openAMRobot/openamr-platform-hw/datasheets/ZDmotor/README.md

Contact:
web: [https://zd-motor.com](https://www.zd-motor.com/)

> NINGBO ZHONGDA LEADER INTELLIGENT TRANSMISSION CO.,LTD.     
> trade26@zd-motor.com    
> sales@zd-motor.com
> 
> No.185 1ST,NEW INDUSTRIAL ZONE,ZONGHAN STREET,CIXI ZHEJIANG, CHINA, 315300     

**T: 86 0574 63537171**
