openAMRobot/openamr-platform-hw/datasheets/ZLTech/README.md

ZLTech components.
Wheel: ZLLG80ASM250-L V1.0
Driver: ZLAC8015D
