openAMRobot/openamr-platform-hw/datasheets/ZLTech/wheel_ZLLG80ASM250/readme.md

# ZLTECH ZLLG80ASM250 hub motor

| File | What |
|---|---|
| `ZLLG80ASM250-L-B2 V1.01 double-shaft.pdf` / `.STEP` / `.dwg` | **Selected 2.0 drivetrain part.** Double shaft, integrated brake, 1024-line encoder. Drawing dated 2026-10-09, received from ZLTECH on 2026-10-10. |
| `ZLLG80ASM250-L V3.0single-shaft.*` | Single-shaft version, reference only. |
| `ZLLG80ASM250-L V1.0.zip` | Earlier double-shaft package (2024), superseded by B2 V1.01. |

Key dimensions from the B2 V1.01 drawing: wheel diameter 200 ±2 mm, tyre width 49.4 ±1 mm, hub width 59.2 mm, overall length shaft end to shaft end 167.8 ±0.5 mm, 83.8 ±1 mm from the tyre face to the brake-side shaft end, 40 ±0.5 mm brake-side shaft, shafts M14 x 1.5 with 10 mm flats, cable 600 ±50 mm.
Motor data on the drawing: 24 V, 5.5 Nm rated, 16 Nm peak, 6.5 A rated, 19 A peak, 200 rpm rated, 260 rpm peak, 15 pole pairs, tyre rubber Shore A 65 ±5.
**Maximum load: 120 kg per pair** (ZLTECH written answer of 18 Oct 2026). The B2 V1.01 drawing states 100 kg per 2 sets.
Brake per ZLTECH written answer of 18 Oct 2026: power-off brake (engaged with power off), 24 V DC, 12.5 W per motor, 6 Nm holding torque, release time at most 100 ms, engagement time at most 30 ms without a diode or at most 100 ms with a diode. These brake values are not on the drawing.
