openAMRobot/openamr-platform-hw/datasheets/Benewake/TF-Luna/readme.md

# Benewake TF-Luna references

Retrieved 18 October 2026. The vendor supplied both PDFs as en.pdf, so the original filenames are retained in separate subfolders.

## Datasheet/en.pdf
- Source: https://ai.benewake.com/en/resources/technical-documents/tf-luna-datasheet/
- Document: PD-TF-Luna-Datasheet-A05
- Revision: A05
- Date: ©2024; no specific issue date printed
- SHA-256: d080033ececa32866ed9361ae04f6d25d8dbdcd478cd2961be0360b241249718
- OpenAMRobot document: OpenAMRobot_NUCLEO-H723ZG_Pin_Map_Draft.docx

## User-Manual/en.pdf
- Source: https://ai.benewake.com/en/resources/technical-documents/tf-luna-user-manual/
- Document: TF-Luna User Manual; no document number printed
- Revision/date: REV: 01/04/2024; ©2024
- SHA-256: 36dfae2e9d6a298624889c5036cfdef9b191c9f44239b7f58ffcef685d9c28e7
- OpenAMRobot document: OpenAMRobot_NUCLEO-H723ZG_Pin_Map_Draft.docx
