openAMRobot/openamr-platform-hw/datasheets/ZDmotor/Driver_ZD_article.jpg

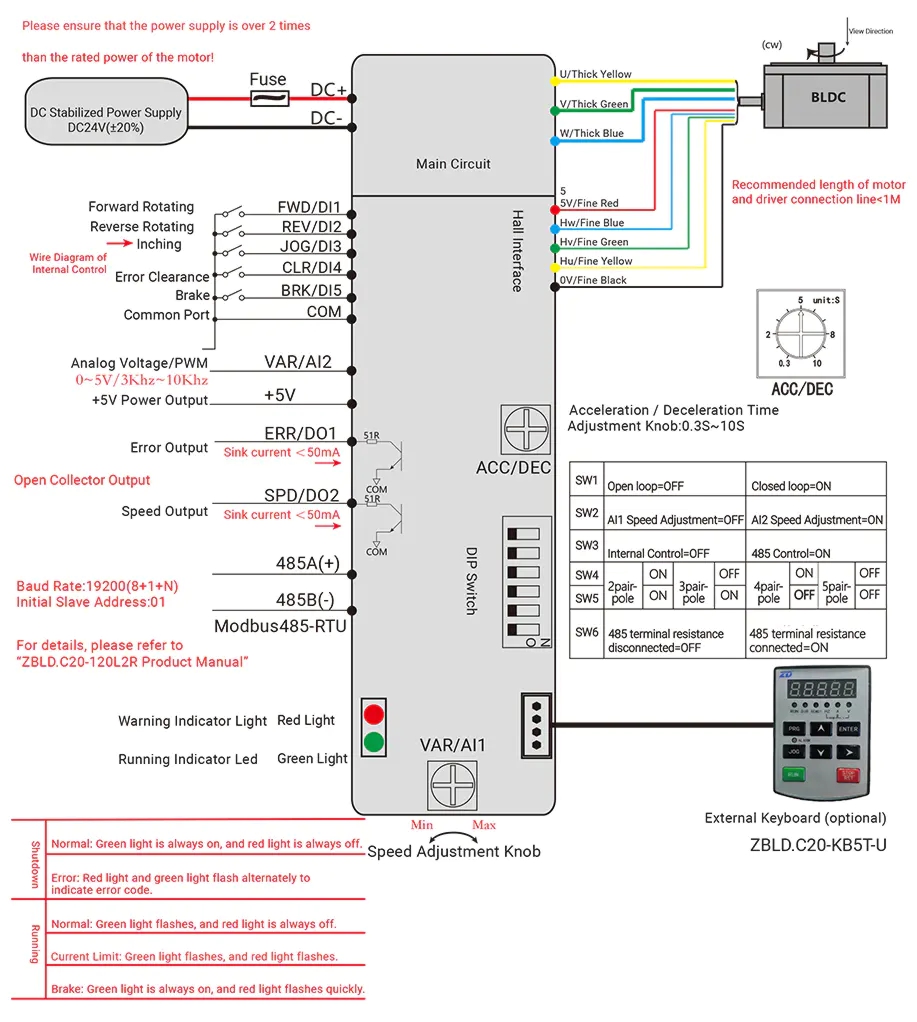
datasheets/ZDmotor/Driver_ZD_article.jpg
