openAMRobot/openamr-platform-hw/mechanical/renderings/AMR_bottom_view.png

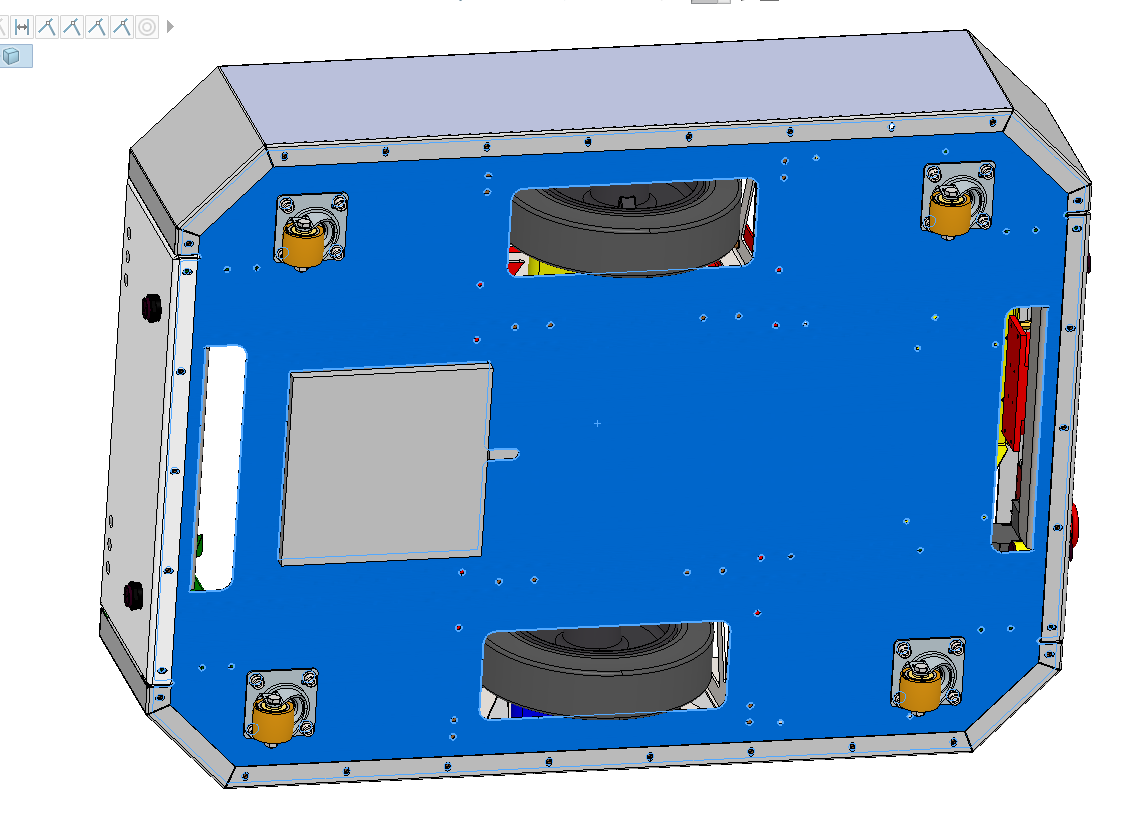
mechanical/renderings/AMR_bottom_view.png
