openAMRobot/openamr-platform-hw/mechanical/renderings/AMR_front_view_trasparent.png

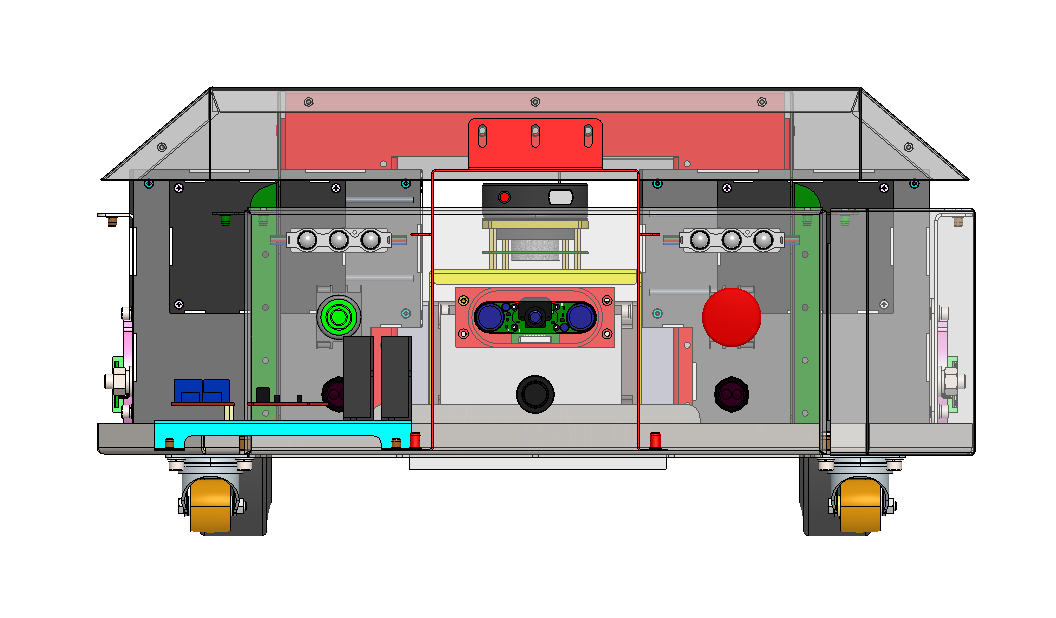
mechanical/renderings/AMR_front_view_trasparent.png
