openAMRobot/openamr-platform-hw/mechanical/renderings/AMR_side_view.jpg

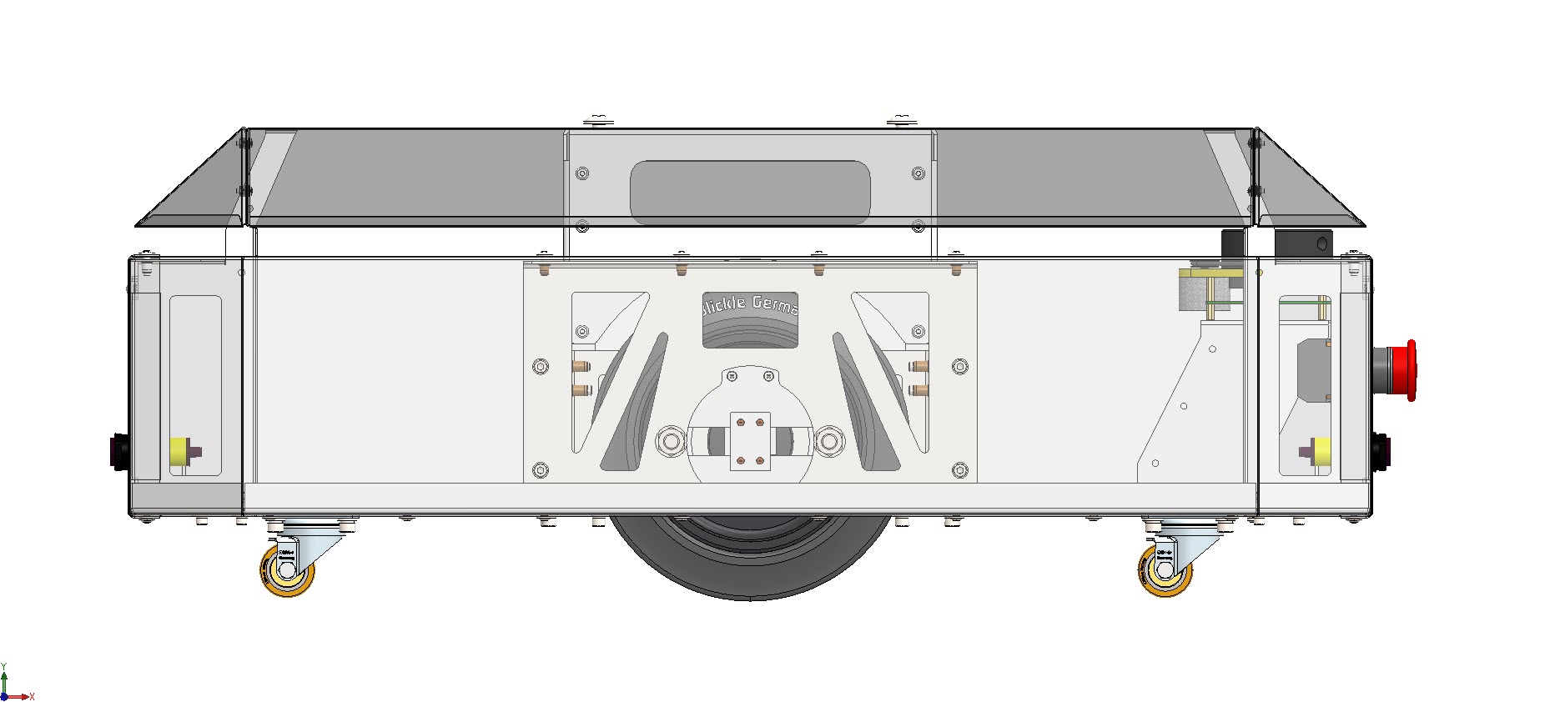
mechanical/renderings/AMR_side_view.jpg
