openAMRobot/openamr-platform-hw/mechanical/renderings/AMR_side_view_transparent.png

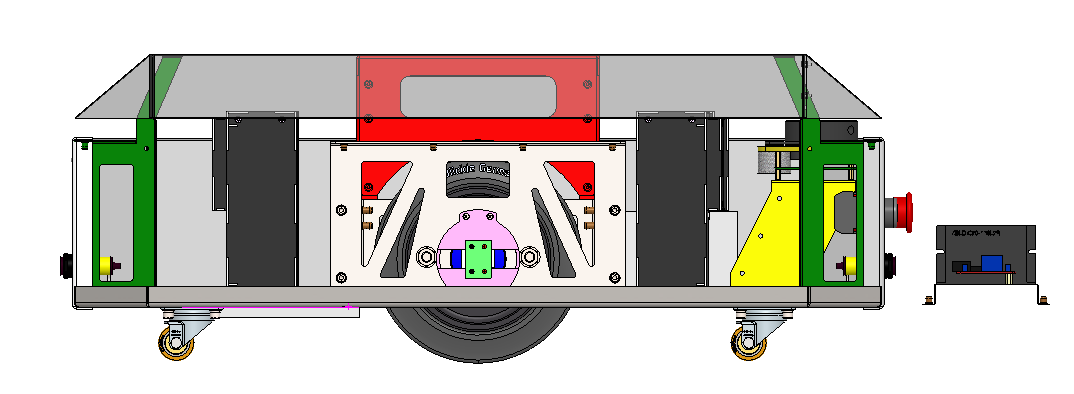
mechanical/renderings/AMR_side_view_transparent.png
