openAMRobot/openamr-platform-hw/mechanical/renderings/AMR_views.jpg

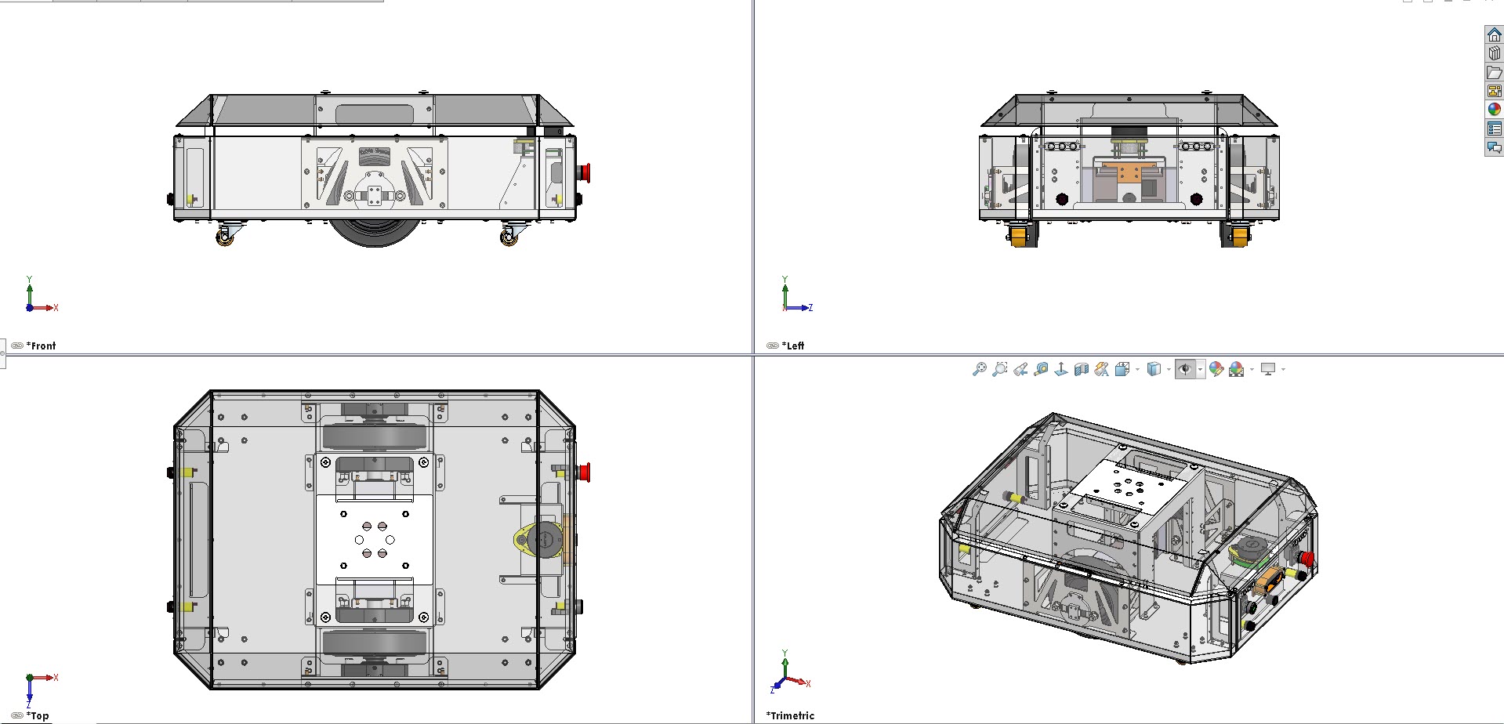
mechanical/renderings/AMR_views.jpg
