openAMRobot/openamr-platform-hw/mechanical/renderings/MMP_01.jpg

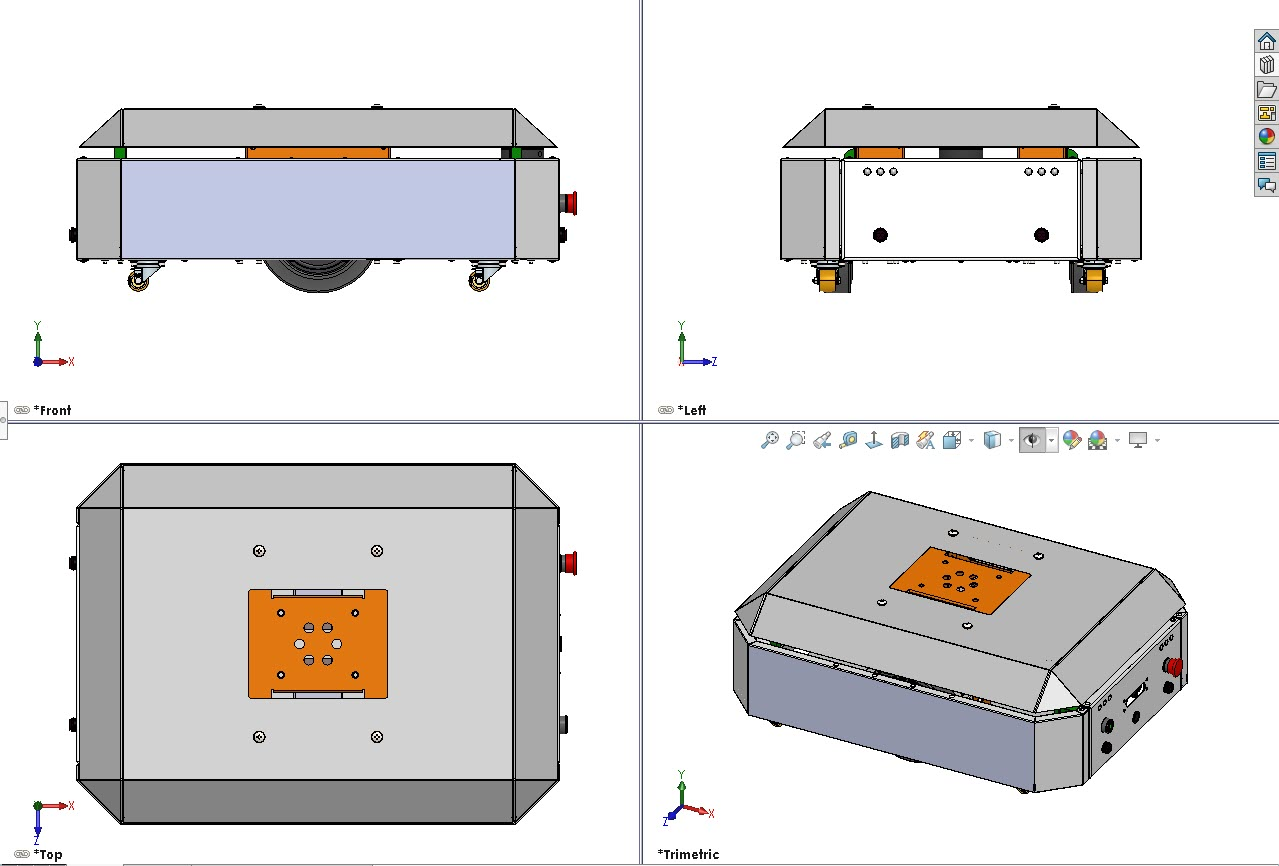
mechanical/renderings/MMP_01.jpg
