openAMRobot/openamr-platform-hw/mechanical/renderings/MMP_02.jpg

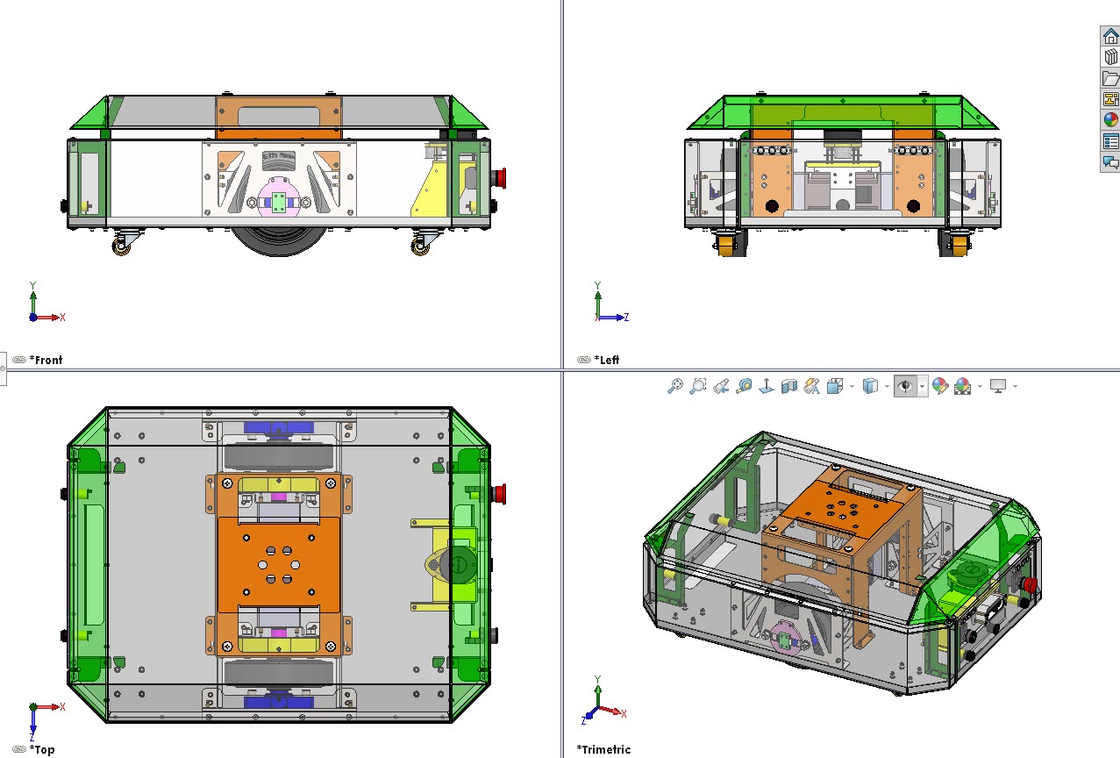
mechanical/renderings/MMP_02.jpg
