openAMRobot/openamr-platform-hw/mechanical/renderings/MMP_03.jpg

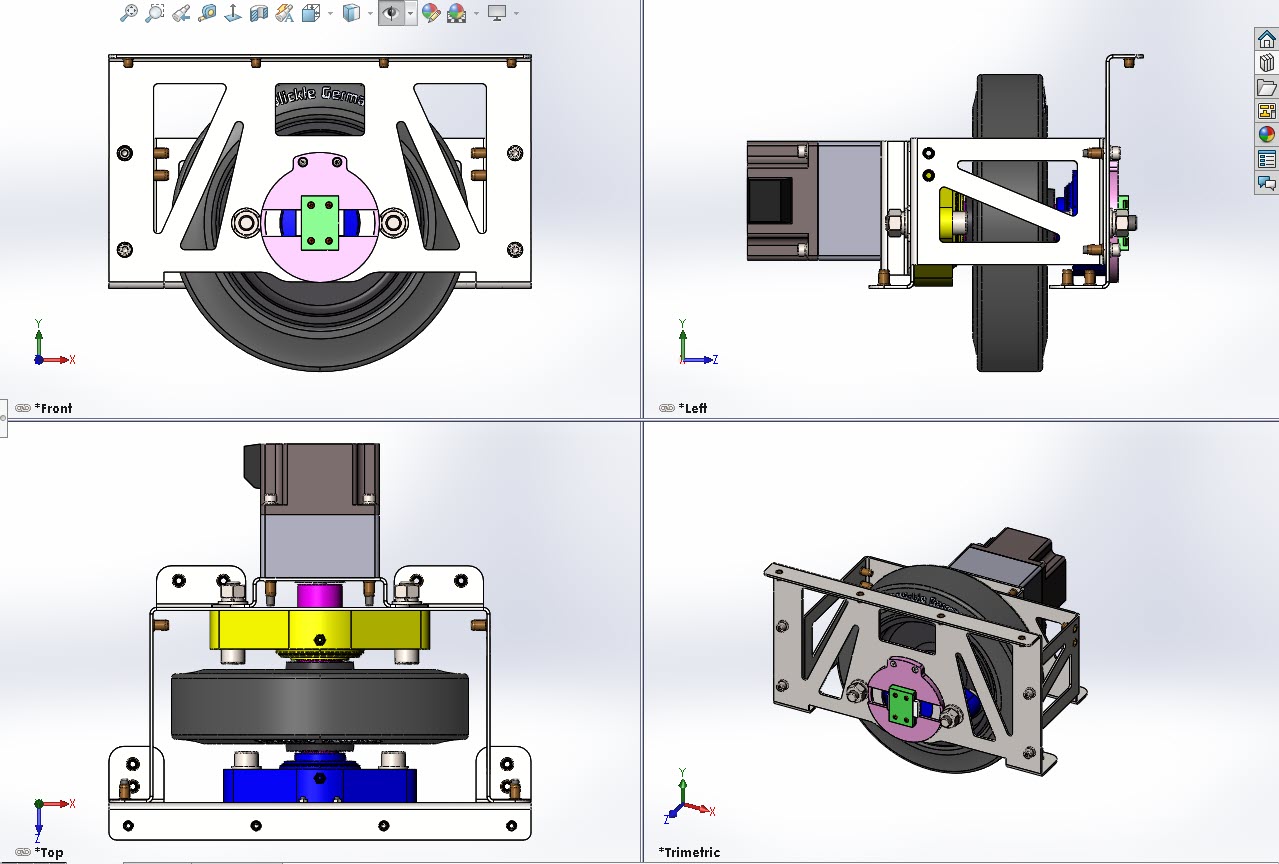
mechanical/renderings/MMP_03.jpg
