openAMRobot/openamr-platform-hw/mechanical/renderings/MMP_04.jpg

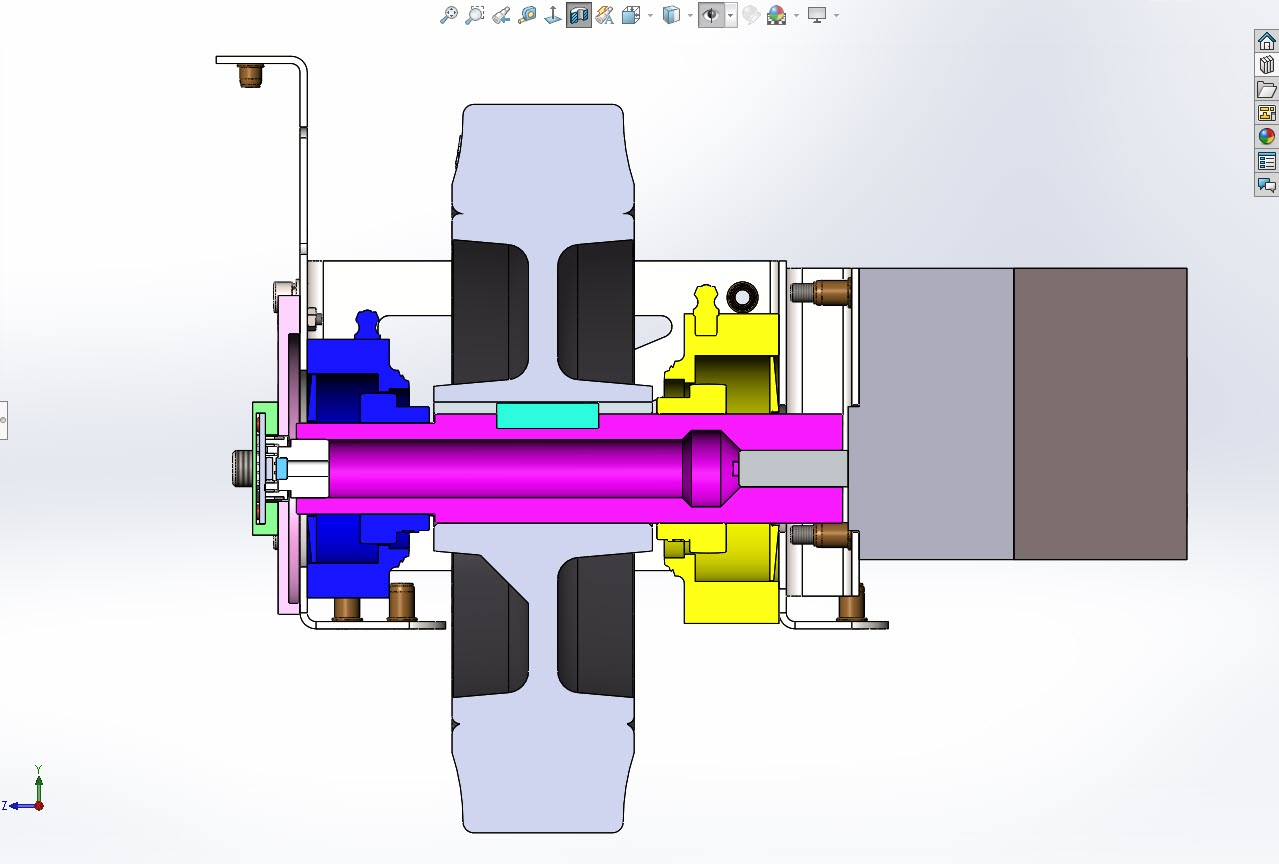
mechanical/renderings/MMP_04.jpg
