openAMRobot/openamr-platform-hw/mechanical/renderings/MMP_05.jpg

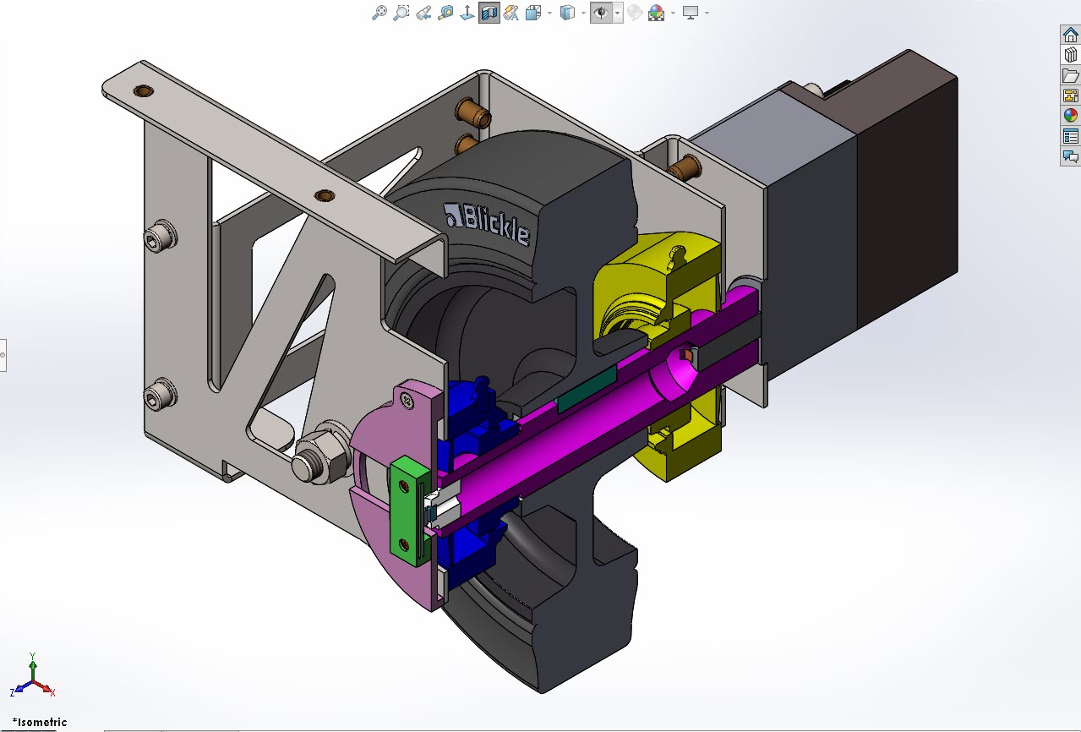
mechanical/renderings/MMP_05.jpg
