openAMRobot/openamr-platform-hw/mechanical/renderings/OpenAMR_03.png

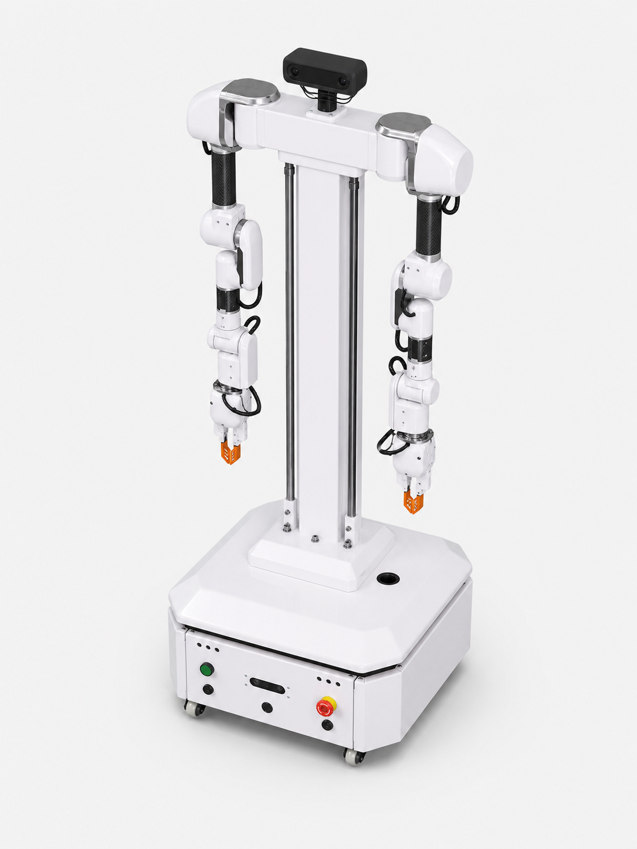
mechanical/renderings/OpenAMR_03.png
