openAMRobot/openamr-platform-hw/mechanical/renderings/OpenAMR_04.png

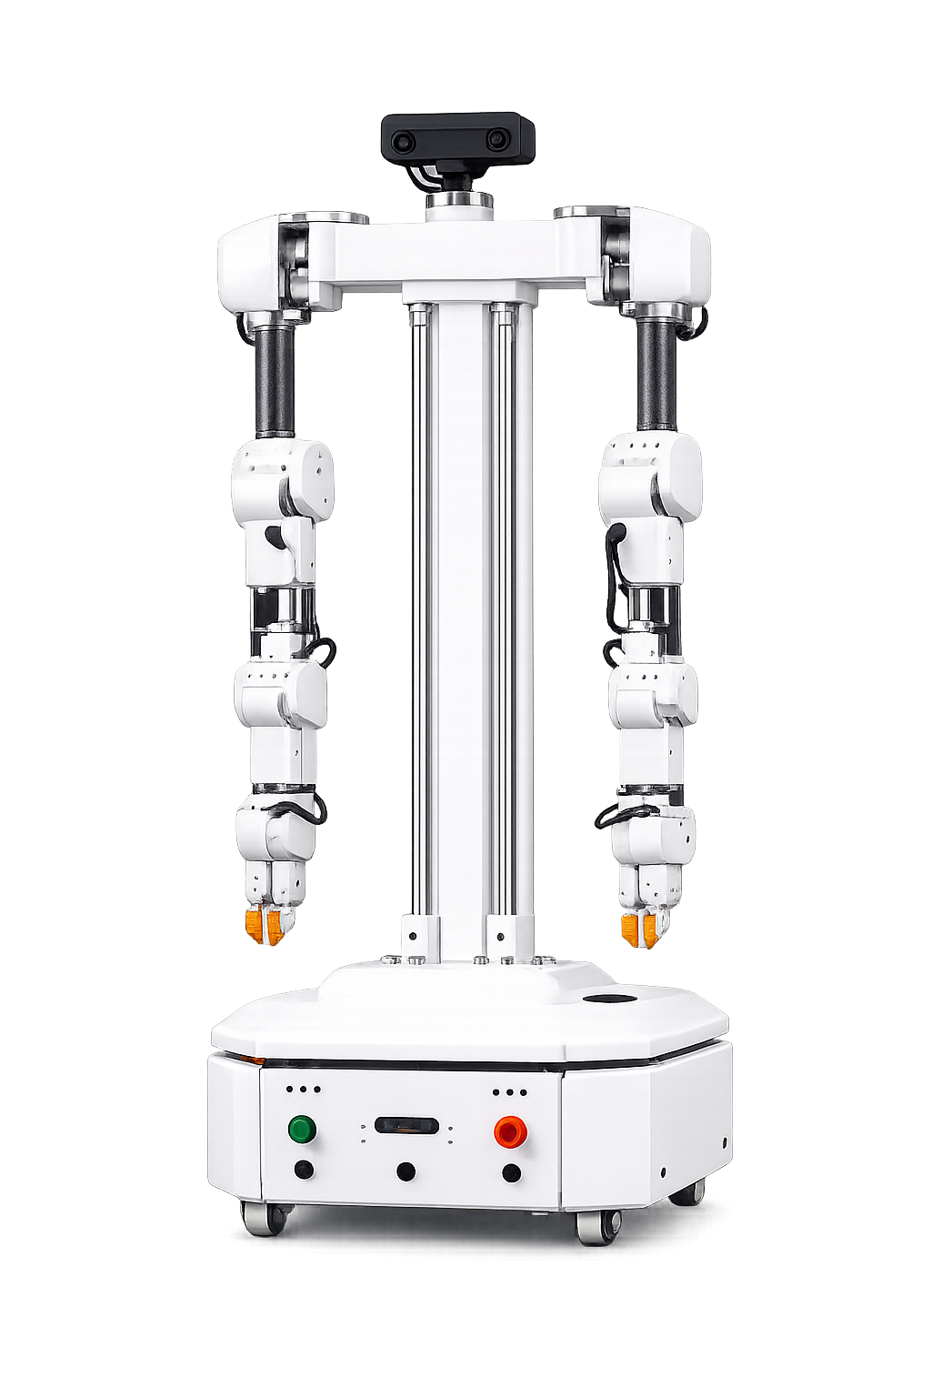
mechanical/renderings/OpenAMR_04.png
