openAMRobot/openamr-platform-hw/mechanical/renderings/OpenAMR_05.png

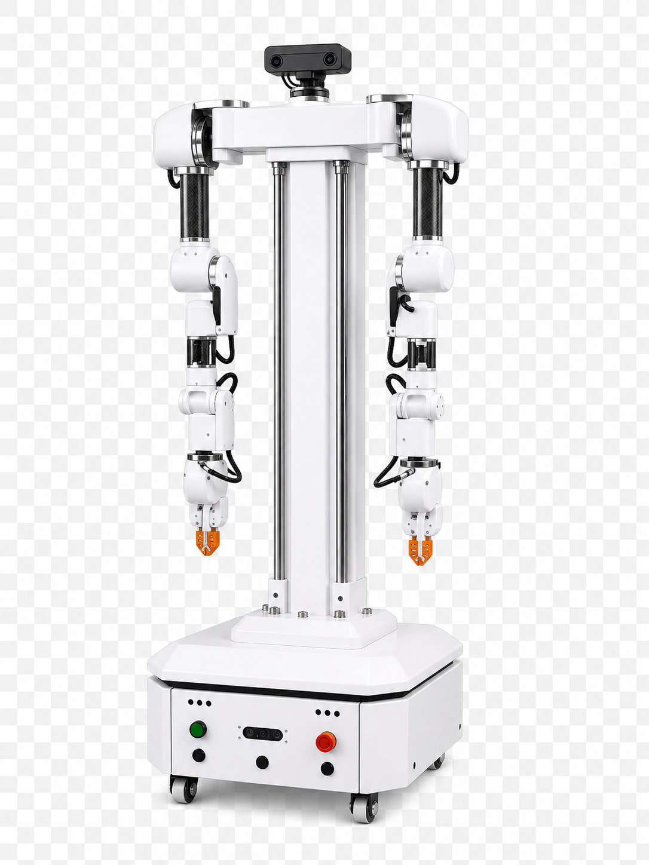
mechanical/renderings/OpenAMR_05.png
