openAMRobot/openamr-platform-hw/mechanical/renderings/OpenAMR_10.png

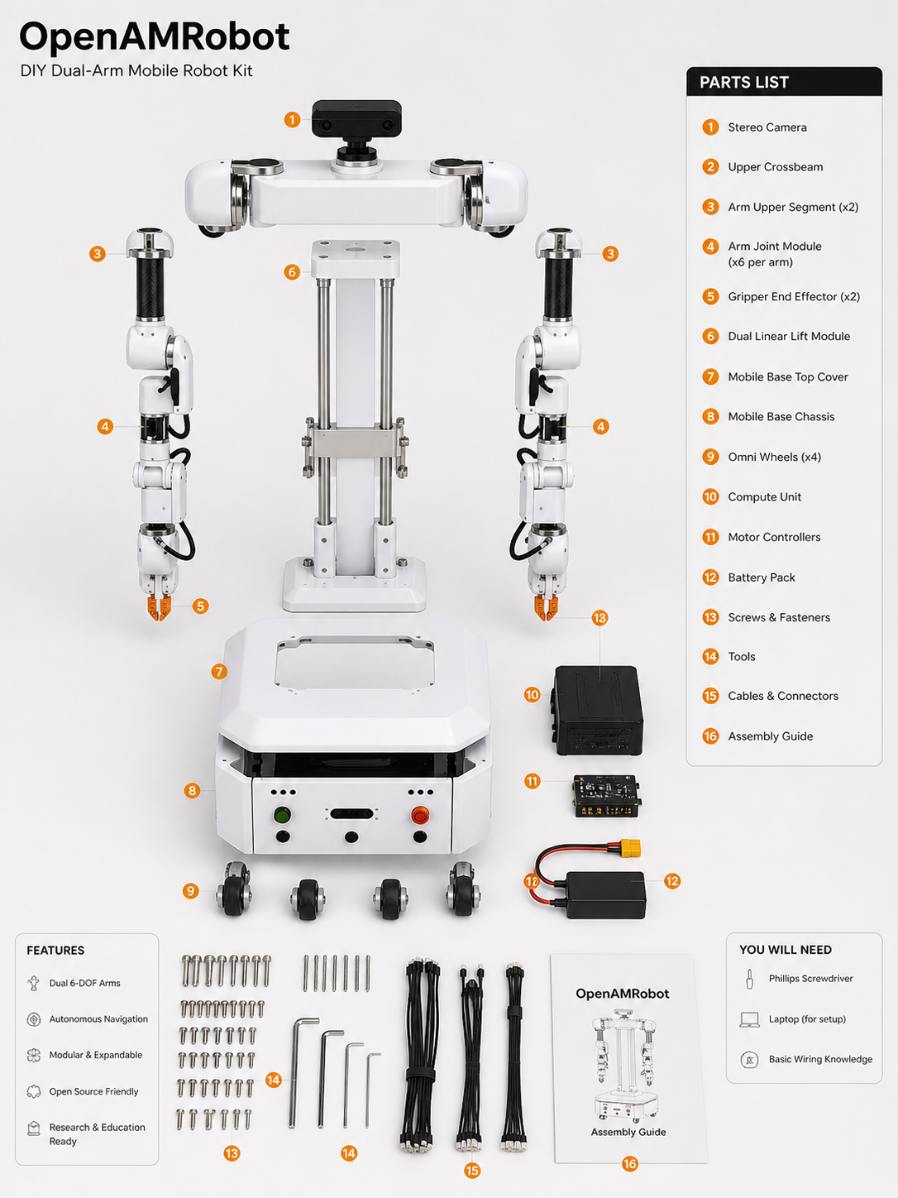
mechanical/renderings/OpenAMR_10.png
