openAMRobot/openamr-platform-hw/mechanical/renderings/OpenAMR_15_c.png

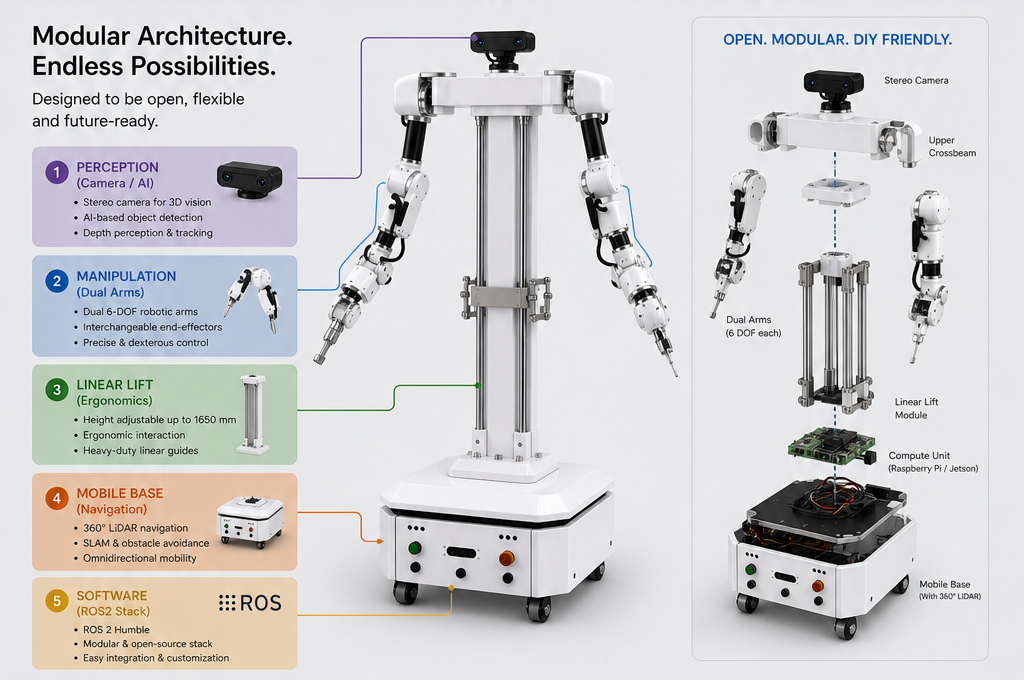
mechanical/renderings/OpenAMR_15_c.png
