openAMRobot/openamr-platform-hw/mechanical/renderings/OpenAMRobot_AI_ecosystem.png

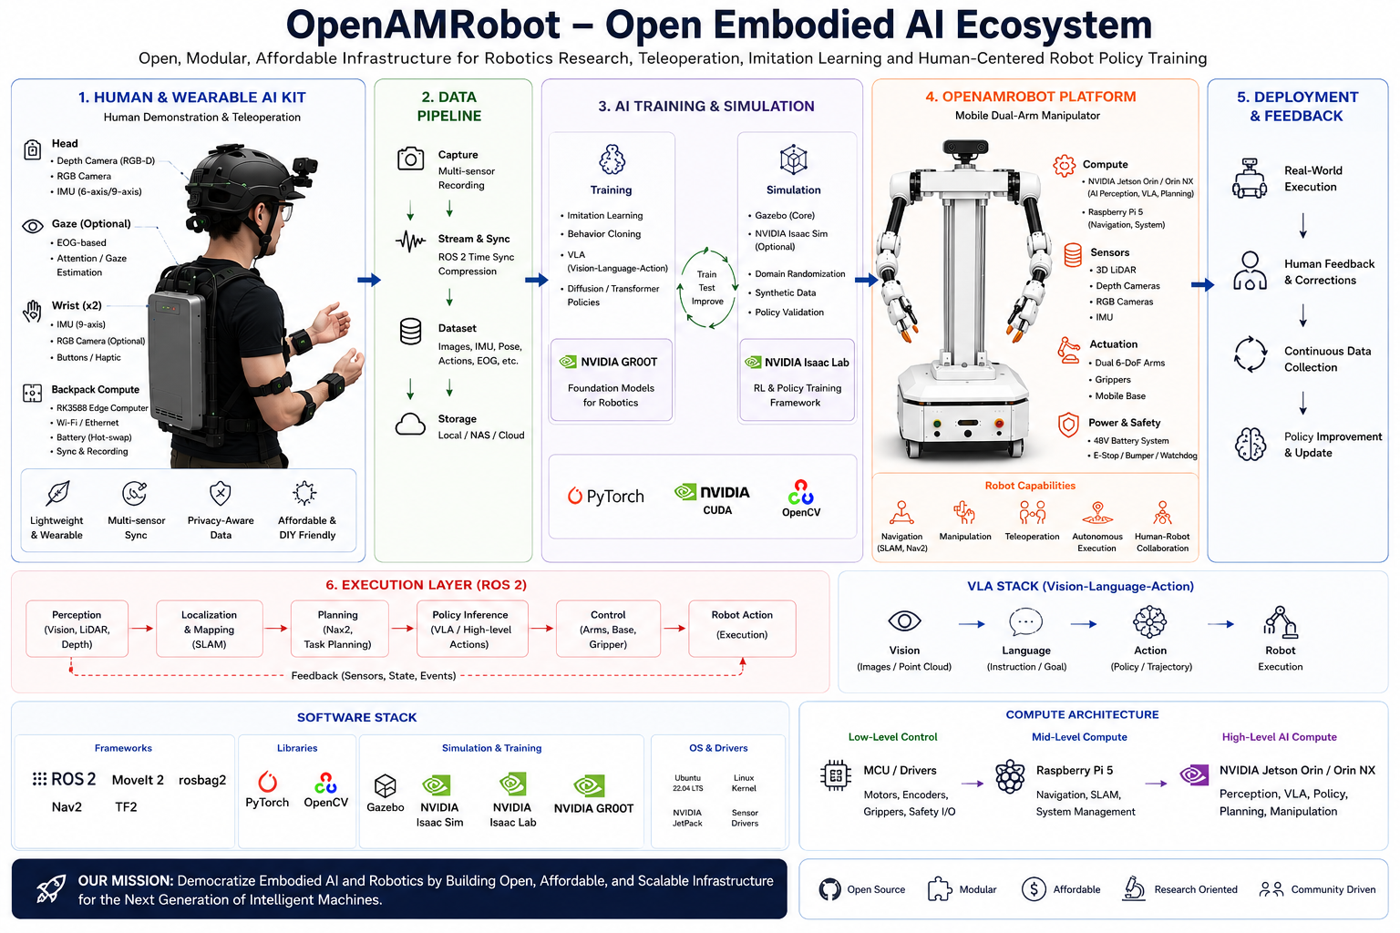
mechanical/renderings/OpenAMRobot_AI_ecosystem.png
