openAMRobot/openamr-platform-hw/manufacturing/bom/components-bom.md

# Components — Bill of Materials & datasheets

*Last updated: 2026-06-19.* Identification done by reading the real labels on the robot + manufacturer
datasheets. Status: ✅ = confirmed (label + datasheet), ⏳ = to read the exact label/marking.

> **Two BOMs, by scope.** This file is the **electrical / electronic** BOM (compute, drivers, motors,
> sensors, power). The **mechanical** BOM — sheet-metal parts, fasteners, technological operations, and
> the Blickle wheel/castor — is [`mechanical-bom.md`](mechanical-bom.md) + the source workbook
> [`BOM_specs_MMP.xlsx`](BOM_specs_MMP.xlsx). Component datasheets are under [`../../datasheets/`](../../datasheets/).

| # | Component | Exact name / part number | Status | Datasheet / source |
|---|---|---|---|---|
| 1 | Microcontroller | **Teensy 4.0** (MCU NXP **i.MX RT1062**, Cortex-M7 600 MHz) | ✅ | [pjrc.com/store/teensy40](https://www.pjrc.com/store/teensy40.html) |
| 2 | Motor drivers ×2 | **ZBLD.C20-120L2R** (Ningbo Zhongda Leader / ZD) | ✅ | [manual V1.02 (PDF)](https://image.yhdfa.com/Uploads/Picture/PDF/FZ02_11/ZBLD.C20.pdf) · [product](https://www.zd-motor.com/product/ZBLD.C20-120L2R-64.html) |
| 3 | Motors ×2 | **Z4BLD60-24GN-30S** (ZD geared BLDC, 60 W / 24 V / 3.8 A / 3000 rpm / **P=5**) | ✅ nameplate | [analog F5B60-24GN-30S spec](https://www.omc-stepperonline.com/24v-60w-100rpm-geared-brushless-dc-motor-4-18nm-591-94oz-in-30-1-spur-gearbox-f5b60-24gn-30s-5gn30k) · [ZD](https://en.zd-motor.com/) |
| 4 | Encoders ×2 | **AMS AS5040** (magnetic, quadrature A/B, marking "AS5040 AB 2.2") | ✅ | [AS5040 datasheet (ams, PDF)](https://www.mouser.com/datasheet/2/588/AS5040_DS000374_4_00-2066720.pdf) |
| 5 | IMU | **TDK InvenSense MPU-6500** (board silk says "MPU-6050"/GY-521, but the chip is a 6500) | ✅ | MPU-6500 datasheet (TDK/InvenSense) |
| 6 | LiDAR | **Slamtec RPLIDAR A1** (A1M8, by shape) | ⏳ confirm sticker | [slamtec.com RPLIDAR A1](https://www.slamtec.com/en/Lidar/A1) |
| 7 | Camera | **Sony IMX708** = Raspberry Pi **Camera Module 3 NoIR** | ✅ | [raspberrypi.com camera-3](https://www.raspberrypi.com/products/camera-module-3/) |
| 8 | SBC | **Raspberry Pi 5** (Model B Rev 1.1, **8 GB** RAM — confirmed 2026-07-06 on the current board) | ✅ | [raspberrypi.com Pi 5](https://www.raspberrypi.com/products/raspberry-pi-5/) |
| 9 | DC-DC 24 V→5 V | generic **~300 W 20 A CC/CV buck** (toroid + 2 trimpots) | ⏳ no clear model | (generic) |
| 10 | Battery | **any 24 V pack** (chemistry up to you). Reference build: 4× **DM12-7S** 12 V **7 Ah** lead-acid (AGM), 2 in series → 24 V | ✅ | DM12-7S SLA datasheet (reference; any 24 V source works) |
| 11 | AC/DC 230→24 V | unknown | ⏳ read label | — |

## Key specs that affect configuration

### Motors — Z4BLD60-24GN-30S (ZD geared BLDC)
*Nameplate read 2026-06-19: 60 W, 24 VDC, 3000 RPM, 3.8 A, Class B Cont, IP20, **P=5**, dated 2021/07/11.*
- **3-phase, P=5 → 5 pole pairs** (confirmed on the nameplate), 24 V, **60 W**, rated current **3.8 A**.
- Motor **3000 rpm**, **spur gearbox 1:25** (gearbox **`4GN 25K`**, confirmed by the OpenAMRobot
  [sizing calculations](../../datasheets/motor-sizing-calculations.md) and the mechanical BOM) → **120 rpm
  at the wheel** (rated torque ~3.48 N·m at 25:1). ⚠️ The motor suffix **`-30S`** is a ZD series code,
  **not** the ratio — the gearbox is 4GN 25K = **25:1** (an earlier "~30:1" here was inferred from an
  analog part number and is superseded).
- **Hall sensors** for the driver's commutation (separate from the AS5040 encoder).
- ⚠️ **Pole pairs = 5** → the driver **DIP SW4/SW5** must be set for 5 pole pairs. **Set to ON/ON (= 5 pp)
  on 2026-06-19** (were OFF/OFF = 2 pp, wrong). A wrong pole-pair setting throws off the driver's
  closed-loop speed scaling (irrelevant in the current open-loop config, but set correctly). See
  [motors-drivers.md](../../electrical/motor_control/motors-drivers.md).
- ⚠️ **Gearbox 1:25** → odometry: `COUNTS_PER_REV = 1024` must be **per wheel revolution**.
  The firmware works at wheel scale (`MOTOR_MAX_RPM 80` = the configured cap, a modest headroom below
  the 120 rpm mechanical output; open-loop ~14 rpm at 20 % PWM), so the **AS5040 reads at wheel scale**
  (mounted on the output side / 1024 cnt = 1 wheel rev). **Still verify physically**: drive exactly 1 m,
  compare `/odom`.

### Drivetrain dimensions (for kinematics / odometry)
**Ground truth = the firmware config** (`lino_base_config.h`), physically measured:
- **Wheel diameter = 0.2 m** (radius 0.10 m).
- **Track (wheel separation) = 0.46 m** (`LR_WHEELS_DISTANCE`), **confirmed by tape-measure**
  (centre-to-centre of the two wheels). The CAD/URDF value of 0.4075 m is **wrong** (CAD artifact) —
  use 0.46 m; the sim `robot.sdf` still needs correcting (see the sim note below).
- With the firmware cap (`MOTOR_MAX_RPM 80` × `MAX_RPM_RATIO 0.85` = 68 rpm) → **max linear ≈ 0.71 m/s**
  (mechanical no-load ≈ **1.26 m/s** at the full **120 rpm** output — see the
  [sizing calculations](../../datasheets/motor-sizing-calculations.md)); rated torque **~3.48 N·m/wheel** (25:1).
  Reliable low-speed floors (measured on the ground): **linear 0.04–0.05 m/s, angular 0.15 rad/s** — see
  [motors-drivers.md](../../electrical/motor_control/motors-drivers.md) "measured velocity floors".

> ⚠️ **Do NOT use 0.046533 m as the wheel radius.** Earlier revisions of this BOM listed a wheel radius
> of 0.046533 m (⌀ 0.093 m) "measured on the real robot" — that was **wrong**. `0.046533` is the wheel
> **axle height (Z)** in the CAD-exported URDF, mis-propagated into the Gazebo `robot.sdf` diff-drive
> `wheel_radius` and copied here by mistake. The physical wheel is ⌀ 0.2 m (firmware, measured).
>
> **Latent simulation bug (openamr-platform-sw):** `robot.sdf` uses `wheel_radius 0.046533` /
> `wheel_separation 0.4075` while the wheel's own visual/collision cylinder is `radius 0.11` — so sim
> odometry/kinematics are scaled ~2× vs the visible model. Fix in `openamrobot_description`:
> set the diff-drive `wheel_radius` to 0.10 and `wheel_separation` to 0.46.

### Drivers — ZBLD.C20-120L2R
- **24 V ±20 %**, output **7.5 A**, **120 W**, open/closed loop (±0.5 %), ACC/DEC 0.3–10 s, 5 DI (NPN) / 2 DO.
- Speed command: internal knob (**VAR/AI1**), external **analog 0–5/10 V**, or **PWM 0–20 kHz** → on this
  robot the Teensy PWM goes to **VAR/AI2** (SW2=ON selects AI2). See [wiring-pinout.md](../../electrical/wiring/wiring-pinout.md).

### Encoders — AMS AS5040
- 10-bit magnetic; **default incremental = 256 PPR → 1024 counts/rev** in quadrature = `COUNTS_PER_REV`. ✅
- Supply **4.5–5.5 V**, but an **internal regulator allows 3.3 V operation**. **Output high level = supply
  voltage** → powered at 5 V it drove **5 V** on A/B (measured ~4 V overvoltage into the non-5 V-tolerant
  Teensy 4.0). **Fix APPLIED 2026-06-19:** supply moved to the **3.3 V** rail → 3.3 V outputs → safe.
  (Alternatives had it browned out: series R / divider / level-shifter.) See
  [encoders.md](../../electrical/sensors/encoders.md).

### Battery — 24 V (reference: DM12-7S)
- The design takes **any 24 V battery**. Reference build: **12 V, 7 Ah** sealed lead-acid (AGM), a pair
  in series = **24 V 7 Ah**. Any 24 V chemistry (LiFePO4 / Li-ion) works too — mind its own BMS/charger
  and adjust the voltage thresholds in [power.md](../../electrical/power_distribution/power.md). Batteries
  sag under load. ⚠️ No fuse / no disconnect currently — see the safety gaps in [power.md](../../electrical/power_distribution/power.md).
  Fuse sizing: 2 motors × **3.8 A** (nameplate) ≈ 7.6 A nominal + DC-DC → a **~15–20 A** fuse (above
  nominal, below the wire/battery limit). ⚠️ This is above *nominal*, not the *stall* current (a jammed
  motor draws well above 3.8 A) — confirm the stall current before finalising.

## Still to read off the robot
- **LiDAR**: confirm the model sticker (A1M8 vs other).
- **DC-DC buck**: any printed model / the regulator IC.
- **AC/DC 230→24 V converter**: brand + model + rating.
- **Gearbox**: ~~confirm the ratio~~ — **done: `4GN 25K` = 1:25** (matches the OpenAMRobot sizing calcs).
