openAMRobot/openamr-platform-hw/manufacturing/bom/BOM_specs_MMP.xlsx

Sheet: Сomposition
 |  |  |  |  |  |  |  |  | MMP - Multipurpose mobile platform - parts and assemblies
3D-model | PDF | Dxf | STEP | Drawing | 3D-PDF | № | Part number |  |  | Description | Q-ty for 1 platform | Material | Covering | Notes
TRUE | FALSE | FALSE | TRUE | FALSE | FALSE | 0.0.0 | MMP.00.00.00.000 |  |  | Multipurpose mobile platform | 1
TRUE | TRUE | TRUE | TRUE | TRUE | FALSE | 0.0.1 | MMP.00.00.00.001 |  |  | Front panel | 1 | Steel EN 1.0114, s2 | RAL9016
TRUE | TRUE | TRUE | TRUE | TRUE | FALSE | 0.0.2 | MMP.00.00.00.002 |  |  | Back panel | 1 | Steel EN 1.0114, s2 | RAL9016
TRUE | TRUE | TRUE | TRUE | TRUE | FALSE | 0.0.3 | MMP.00.00.00.003 |  |  | Side panel | 2 | Steel EN 1.0114, s0,8 | RAL9016
TRUE | FALSE | FALSE | TRUE | FALSE | FALSE | 0.0.4 | РТ1.00.00.032 |  |  | Camera upper body | 1 |  |  | 3d-printing
TRUE | FALSE | 0 | TRUE | FALSE | TRUE | 1 | MMP.01.00.00.000 |  |  | Cover assembly | 1
TRUE | TRUE | TRUE | TRUE | TRUE | FALSE | 1.1 |  | MMP.01.00.00.001 |  | Cover | 1 | Steel EN 1.0114, s0,8 | RAL9016
TRUE | TRUE | TRUE | TRUE | TRUE | FALSE | 1.2 |  | MMP.01.00.00.002 |  | Cover flange | 2 | Steel EN 1.0114, s0,8 | RAL9016
TRUE | FALSE | 0 | TRUE | FALSE | TRUE | 2 | MMP.02.00.00.000 |  |  | Base assembly | 1
TRUE | TRUE | TRUE | TRUE | TRUE | FALSE | 2.1 |  | MMP.02.00.00.001 |  | Base |  | Steel EN 1.0114, s2 | RAL9016
TRUE | FALSE | FALSE | TRUE | FALSE | TRUE | 3 | MMP.03.00.00.000 |  |  | Wheel assembly | 2
TRUE | TRUE | TRUE | TRUE | TRUE | FALSE | 3.1 |  | MMP.03.00.00.001 |  | Wheel bracket outer | 2 | Steel EN 1.0114, s2 | RAL9016 | Threaded holes (М3, М4)
TRUE | TRUE | TRUE | TRUE | TRUE | FALSE | 3.2 |  | MMP.03.00.00.002 |  | Wheel bracket inner | 2 | Steel EN 1.0114, s2 | RAL9016 | Threaded holes (М4)
TRUE | TRUE | TRUE | TRUE | TRUE | FALSE | 3.3 |  | MMP.03.00.00.003 |  | Motor bracket | 2 | Steel EN 1.0114, s2 | RAL9016
TRUE | TRUE | FALSE | TRUE | TRUE | FALSE | 3.4 |  | MMP.03.00.00.004 |  | Drive shaft | 2 | Steel 37Cr4
TRUE | FALSE | FALSE | TRUE | FALSE | TRUE | 3.5 |  | РТ1.00.00.240 |  | Magnetic encoder | 2
TRUE | FALSE | FALSE | TRUE | FALSE | FALSE | 3.5.1 |  |  | РТ1.00.00.241 | Adapter | 2 |  |  | 3d-printing
TRUE | FALSE | FALSE | TRUE | FALSE | FALSE | 3.5.2 |  |  | РТ1.00.00.242 | Bracket | 2 |  |  | 3d-printing
TRUE | FALSE | FALSE | TRUE | FALSE | FALSE | 3.5.3 |  |  | РТ1.00.00.243 | Cover | 2 |  |  | 3d-printing
TRUE | FALSE | FALSE | TRUE | FALSE | TRUE | 4 | MMP.04.00.00.000 |  |  | Center bracket assembly | 1
TRUE | TRUE | TRUE | TRUE | TRUE | FALSE | 4.1 |  | MMP.04.00.00.001 |  | Center bracket |  | Steel EN 1.0114, s2 | RAL9016
TRUE | FALSE | FALSE | TRUE | FALSE | TRUE | 5 | MMP.05.00.00.000 |  |  | Support assembly | 2
TRUE | TRUE | TRUE | TRUE | TRUE | FALSE | 5.1 |  | MMP.05.00.00.001 |  | Support |  | Steel EN 1.0114, s1,2 | RAL9016
TRUE | FALSE | FALSE | TRUE | FALSE | TRUE | 6 | MMP.05.00.00.000-01 |  |  | Support assembly | 2
TRUE | TRUE | TRUE | TRUE | TRUE | FALSE | 6.1 |  | MMP.05.00.00.001-01 |  | Support |  | Steel EN 1.0114, s1,2 | RAL9016
TRUE | FALSE | FALSE | TRUE | FALSE | TRUE | 7 | MMP.07.00.00.000 |  |  | Lidar support assembly | 1
TRUE | TRUE | TRUE | TRUE | TRUE | FALSE | 7.1 |  | MMP.07.00.00.001 |  | Lidar support |  | Steel EN 1.0114, s1,2 | RAL9016
 |  |  |  |  |  |  | - 3D-printed part

Sheet: Components
№ | Description |  | Q-ty for 1 platform, pcs | Link | Part No. | Additional info
1 | Heavy duty drive wheel | Blickle GEVN 200/30H7 | 2 | Link (https://www.blickle.com/product/GEVN-200-30H7-754372) | 4047526113377 | Catalogue (https://www.blickle.com/products/wheel-castor-series/drive-wheels-hub-fitting-wheels-ground-wheels/drive-wheels)
2 | Light duty swivel castor | Blickle LPA-VSTH 35K | 4 | Link (https://www.blickle.com/product/LPA-VSTH-35K-603175) | 4047526603175
3 | Oval flange bearing units | REXNORD UCFL 205 C 655472 (d25) | 2 | Link (http://www.intergear.eu/produkty/dopravniky/rexnord/10Oval-flang-bearing.pdf) | 655472
4 | Oval flange bearing units | REXNORD UCFL 206 C 666412 (d30) | 2 | Link (http://www.intergear.eu/produkty/dopravniky/rexnord/10Oval-flang-bearing.pdf) | 666412
5 | Rivet Nut - M4 | Blind Rivet Nut - Round Thin - Stainless Steel - M4 | 58 | Link (https://www.insertsdirect.com/product/blind-rivet-nut-round-thin-stainless-steel-m4-48) | 100 - 5802159
6 | Rivet Nut - M5 | Blind Rivet Nut - Round Thin - Stainless Steel - M5 | 48 | Link (https://www.insertsdirect.com/product/blind-rivet-nut-round-thin-stainless-steel-m5-49) | 100 - 5802287
7 | Rivet Nut - M6 | Blind Rivet Nut - Round Thin - Stainless Steel - M6 | 16 | Link (https://www.insertsdirect.com/product/blind-rivet-nut-round-thin-stainless-steel-m6-50) | 100 - 5802253
8 | Rivet Nut - M8 | Blind Rivet Nut - Round Thin - Stainless Steel - M8 | 8 | Link (https://www.insertsdirect.com/product/blind-rivet-nut-round-thin-stainless-steel-m8-51) | 100 - 5802182
9 | Feather key | Feather key 4x4x25 DIN 6885-UNI 6604 (former ISO 773) | 2 | Link (http://opis.cz/chiavette/pdf/DIN6885.pdf)
10 | Feather key | Feather key 8x7x28 DIN 6885-UNI 6604 (former ISO 773) | 2
11 | Screwed spacer sleeve | TFF-M3/25 FIX&FASTEN | 4 | Link (https://www.tme.eu/gb/details/tff-m3_25/metal-spacers/fix-fasten/)
12 | BLDC motor | Z4BLD60-24GN-30S/4GN 25K | 2
13 | Laser Range Scanner | RPLIDAR A1-A1M8 | 1 | Link (https://www.slamtec.com/en/Lidar/A1)
14 | Camera | Camera Module NVision Assem | 1
14 | Proximity Sensor | E18-D80NK | 4 | Link (https://datasheetspdf.com/pdf/1311840/tinkbox/E18-D80NK/1)
15 | US Sensor | JSN-SR04T | 1
16 | LED module | 3 LED RGB Module 0.72W SWP | 2

Sheet: Applicability of fasteners
MMP - Applicability of fasteners
№ | Part number | Description | Q-ty, pcs | 3D PDF | Blind Rivet Nut - Round Thin - Stainless Steel - M4 | Blind Rivet Nut - Round Thin - Stainless Steel - M5 | Blind Rivet Nut - Round Thin - Stainless Steel - M6 | Blind Rivet Nut - Round Thin - Stainless Steel - M8 | Blind rivet Al/St 4,0х8, DIN 7337 | Screw М4x16 DIN 912 | Screw М5x20 DIN 912 | Screw М5x70 DIN 912 | Screw М6x20 DIN 912 | Screw М10x45 DIN 912 | Screw М3x12 DIN 965 | Screw М3x8 DIN 966 | Screw М3x12 DIN 967 | Screw М4x12 DIN 967 | Screw М4x16 DIN 967 | Screw М8x25 DIN 967 | Screw М2x8 DIN 7985 | Screw М2x16 DIN 7985 | Screw М2,5x6 DIN 7985 | Screw М3x8 DIN 7985 | Screw М4x16 DIN 7985 | Nut M2 DIN 934 | Nut M3 DIN 934 | Nut M10 DIN 934 | Washer 2 DIN 125 | Washer 2,5 DIN 125 | Washer 3 DIN 125 | Washer 4 DIN 125 | Washer 5 DIN 125 | Washer 6 DIN 125 | Washer 8 DIN 125 | Washer 10 DIN 125 | Spring lock washer 2 DIN 7980 | Spring lock washer 2,5 DIN 7980 | Spring lock washer 3 DIN 7980 | Spring lock washer 4 DIN 7980 | Spring lock washer 5 DIN 7980 | Spring lock washer 6 DIN 7980 | Spring lock washer 10 DIN 7980 | Large size washer 4 DIN 9021 | Screwed spacer sleeve TFF-M3/25 | Feather key 4x4x25 DIN 6885-UNI 6604 (former ISO 773) | Feather key 8x7x28 DIN 6885-UNI 6604 (former ISO 773)
1.1 | Main assembly | Camera to Front panel |  |  |  |  |  |  |  |  |  |  |  |  |  | 4 | 4 |  |  |  |  | 4 |  |  |  | 4 |  |  | 4 |  | 16 |  |  |  |  |  | 4 |  |  |  |  |  |  |  | 4
1.2 |  | Cover to Center bracket |  |  |  |  |  |  |  |  |  |  |  |  |  |  |  |  |  | 4 |  |  |  |  |  |  |  |  |  |  |  |  |  |  | 4
1.3 |  | Lidar to support assembly |  |  |  |  |  |  |  |  |  |  |  |  |  |  |  |  |  |  |  |  | 4 |  |  |  |  |  |  | 4 |  |  |  |  |  |  |  | 4
1.4 |  | Lidar support assembly to base |  |  |  |  |  |  |  |  |  |  |  |  |  |  |  |  |  |  |  |  |  |  | 4 |  |  |  |  |  |  | 4 |  |  |  |  |  |  |  | 4
1.5 |  | Center bracket to base |  |  |  |  |  |  |  |  | 16 |  |  |  |  |  |  |  |  |  |  |  |  |  |  |  |  |  |  |  |  |  | 16 |  |  |  |  |  |  |  | 16
1.6 |  | Side panels |  |  |  |  |  |  |  |  |  |  |  |  |  |  |  | 32
1.7 |  | Front panel - up |  |  |  |  |  |  |  |  |  |  |  |  |  |  |  | 4
1.8 |  | Front panel - down |  |  |  |  |  |  |  |  |  |  |  |  |  |  |  |  | 10
1.9 |  | Support assemblies to base |  |  |  |  |  |  |  | 8 |  |  |  |  |  |  |  |  |  |  |  |  |  |  |  |  |  |  |  |  |  |  |  |  |  |  |  |  |  | 8 |  |  |  | 8
1.10 |  | Light duty swivel castors to base |  |  |  |  |  |  |  |  |  |  | 16 |  |  |  |  |  |  |  |  |  |  |  |  |  |  |  |  |  |  |  |  | 16 |  |  |  |  |  |  |  | 16
1.11 |  | Wheel assemblies to base |  |  |  |  |  |  |  |  | 16 |  |  |  |  |  |  |  |  |  |  |  |  |  |  |  |  |  |  |  |  |  | 16 |  |  |  |  |  |  |  | 16
2 | MMP.01.00.00.000 | Cover assembly | 1 |  |  |  |  |  |  |  |  |  |  |  |  |  |  |  |  |  |  |  |  | 10 |  |  | 10 |  |  |  | 20 |  |  |  |  |  |  |  | 10
3 | MMP.02.00.00.000 | Base assembly | 1 |  | 26 |  | 16
4 | MMP.03.00.00.000 | Wheel assembly | 2 |  | 8 | 40 |  |  |  |  | 8 | 8 |  | 8 | 4 |  |  |  |  |  |  |  |  |  |  |  | 4 | 8 |  |  |  |  | 16 |  |  | 12 |  |  |  |  |  |  | 8 |  |  | 2 | 2
4.1 | РТ1.00.00.240 | Magnetic encoder | 2 |  |  |  |  |  |  |  |  |  |  |  |  |  |  |  |  |  | 8 |  |  |  |  | 8
6 | MMP.04.00.00.000 | Center bracket assembly | 1 |  |  | 8 |  | 8 | 16
7 | MMP.05.00.00.000 | Support assembly | 2 |  | 10
8 | MMP.05.00.00.000-01 | Support assembly | 2 |  | 10
9 | MMP.07.00.00.000 | Lidar support assembly | 1 |  | 4
 |  | Total: |  |  | 58 | 48 | 16 | 8 | 16 | 8 | 40 | 8 | 16 | 8 | 4 | 4 | 4 | 36 | 10 | 4 | 8 | 4 | 4 | 10 | 4 | 12 | 14 | 8 | 4 | 4 | 36 | 4 | 48 | 16 | 4 | 12 | 4 | 4 | 10 | 12 | 32 | 16 | 8 | 8 | 4 | 2 | 2

Sheet: General list of fasteners
№ | Description | Q-ty, pcs
1 | Screw М4x16 DIN 912 | 8
2 | Screw М5x20 DIN 912 | 40
3 | Screw М5x70 DIN 912 | 8
4 | Screw М6x20 DIN 912 | 16
5 | Screw М10x45 DIN 912 | 8
6 | Screw М3x12 DIN 965 | 4
7 | Screw М3x8 DIN 966 | 4
8 | Screw М3x12 DIN 967 | 4
9 | Screw М4x12 DIN 967 | 36
10 | Screw М4x16 DIN 967 | 10
11 | Screw М8x25 DIN 967 | 4
12 | Screw М2x8 DIN 7985 | 8
13 | Screw М2x16 DIN 7985 | 4
14 | Screw М2,5x6 DIN 7985 | 4
15 | Screw М3x8 DIN 7985 | 10
16 | Screw М4x16 DIN 7985 | 4
17 | Nut M2 DIN 934 | 12
18 | Nut M3 DIN 934 | 14
19 | Nut M10 DIN 934 | 8
20 | Blind Rivet Nut - Round Thin - Stainless Steel - M4 | 58
21 | Blind Rivet Nut - Round Thin - Stainless Steel - M5 | 48
22 | Blind Rivet Nut - Round Thin - Stainless Steel - M6 | 16
23 | Blind Rivet Nut - Round Thin - Stainless Steel - M8 | 8
24 | Blind rivet Al/St 4,0х8, DIN 7337 | 16
25 | Washer 2 DIN 125 | 4
26 | Washer 2,5 DIN 125 | 4
27 | Washer 3 DIN 125 | 36
28 | Washer 4 DIN 125 | 4
29 | Washer 5 DIN 125 | 48
30 | Washer 6 DIN 125 | 16
31 | Washer 8 DIN 125 | 4
32 | Washer 10 DIN 125 | 12
33 | Spring lock washer 2 DIN 7980 | 4
34 | Spring lock washer 2,5 DIN 7980 | 4
35 | Spring lock washer 3 DIN 7980 | 10
36 | Spring lock washer 4 DIN 7980 | 12
37 | Spring lock washer 5 DIN 7980 | 32
38 | Spring lock washer 6 DIN 7980 | 16
39 | Spring lock washer 10 DIN 7980 | 8
40 | Large size washer 4 DIN 9021 | 8
41 | Feather key 4x4x25 DIN 6885-UNI 6604 (former ISO 773) | 2
42 | Feather key 8x7x28 DIN 6885-UNI 6604 (former ISO 773) | 2

Sheet: Assembly nuances
№ | Description
1 | Sheet metal parts vary by production. Currently, the parts are designed for the following coefficients and radii: K=0.47: sheet 0.8 mm - R=1.2; sheet 1.2 mm - R=1.5; sheet 2.0 mm - R=2.4.
2 | After bending, parts could be painted.
3 | After painting, we install riveting nuts. It is allowed to install riveting nuts before painting, provided that the threaded part of the nuts is protected from coating.
4 | Screws installed without lock washers - fix with a thread lock (eg Loxeal 55-03).
5 | There may be nuances with block bearings. All details are strongly interconnected and depend on each other.
