openAMRobot/openamr-platform-hw/datasheets/ZLTech/wheel_ZLLG80ASM250/ZLLG80ASM250-L V3.0single-shaft.SLDASM

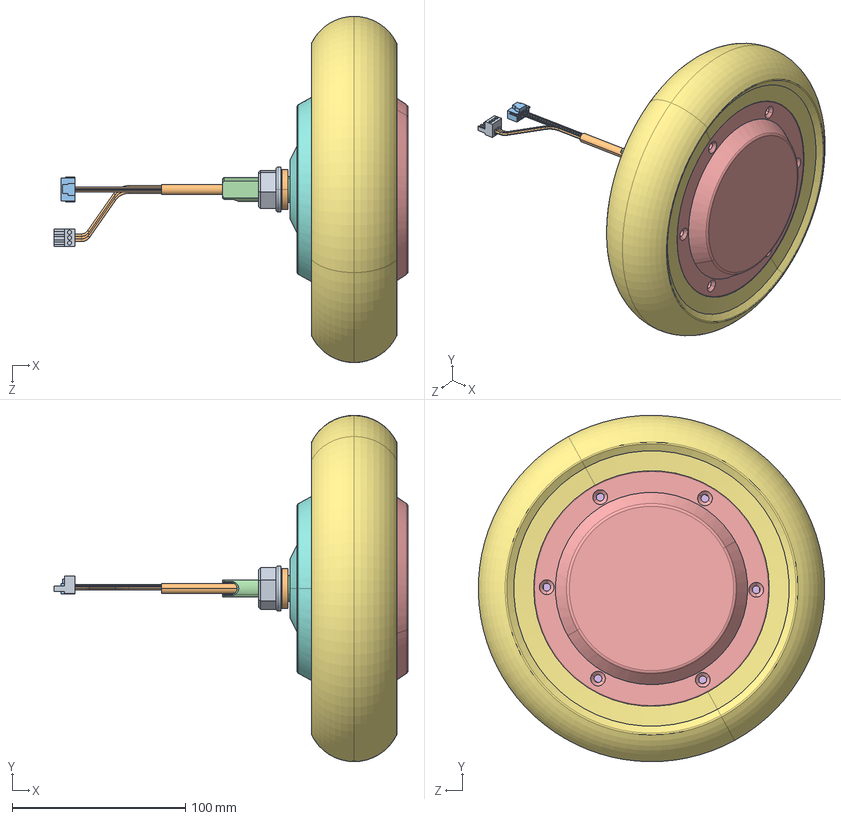
[picture p25: CAD file, 2026-07-09]
datasheets/ZLTech/wheel_ZLLG80ASM250/ZLLG80ASM250-L V3.0single-shaft.SLDASM
204.4 x 200.0 x 199.9 mm
5cun-1.1.stp
5G-shuang_1.1.stp
零件1.1.2.stp
零件1.stp
6.5C-QDG-KaiMo.stp
零件1.1.stp
零件2.1.1.stp
MANIFOLD_SOLID_BREP_6700.stp
零件1.1.2.1.stp
Part1.2.stp
