openAMRobot/openamr-platform-hw/mechanical/cad/production_files/MMP.07.00.00.000 Lidar support assembly.STEP

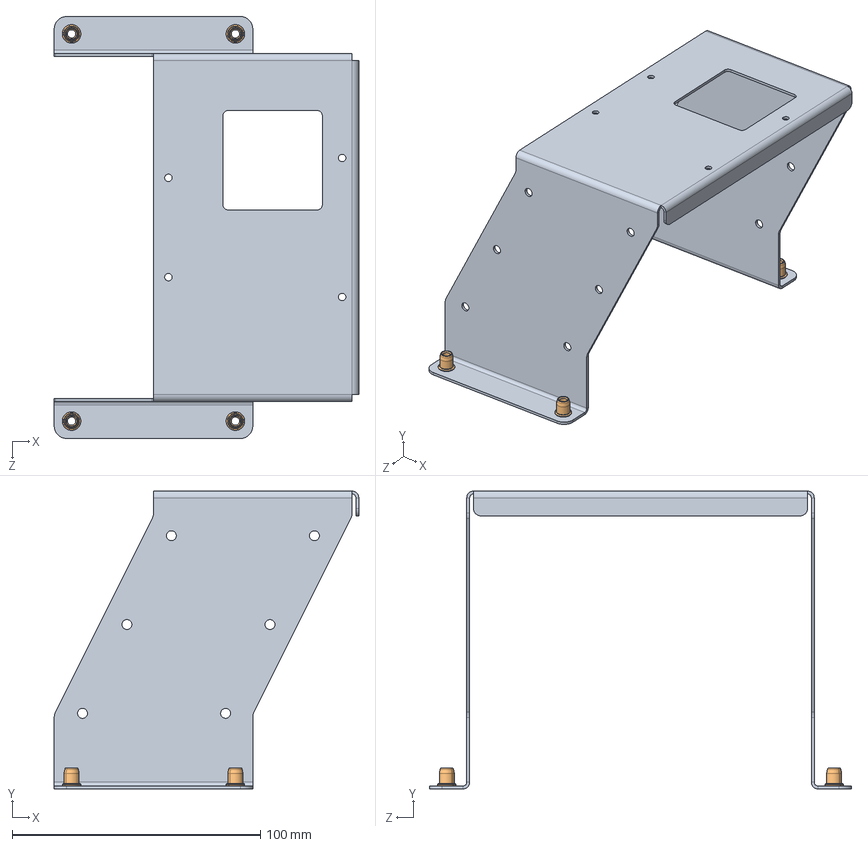
[picture p26: CAD file, 2026-07-09]
mechanical/cad/production_files/MMP.07.00.00.000 Lidar support assembly.STEP
122.7 x 120.0 x 170.0 mm
MMP.07.00.00.001 Lidar support_�� 㬮�砭��
Ãàéêà êëåïàëüíàÿ Ì4_0,5-2 óì. ïîòàé, ñòàëü_ãáâ.  1,2 ¬¬ x 4
