openAMRobot/openamr-platform-hw/mechanical/cad/production_files/MMP.02.00.00.000 Base assembly.STEP

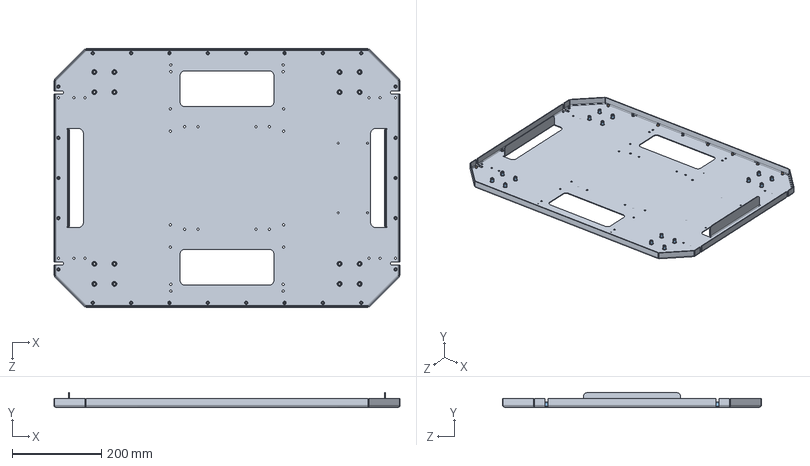
[picture p27: CAD file, 2026-07-09]
mechanical/cad/production_files/MMP.02.00.00.000 Base assembly.STEP
776.0 x 33.2 x 580.0 mm
MMP.02.00.00.001 Base_�� 㬮�砭��
Ãàéêà êëåïàëüíàÿ Ì4_0,5-2 óì. ïîòàé, ñòàëü_ãáâ.  2 ¬¬ x 26
Ãàéêà êëåïàëüíàÿ Ì6_0,5-2,5 óì. ïîòàé, ñòàëü_ãáâ.  1,5 ¬¬ x 16
