openAMRobot/openamr-platform-hw/mechanical/cad/production_files/MMP.01.00.00.000 Cover assembly.STEP

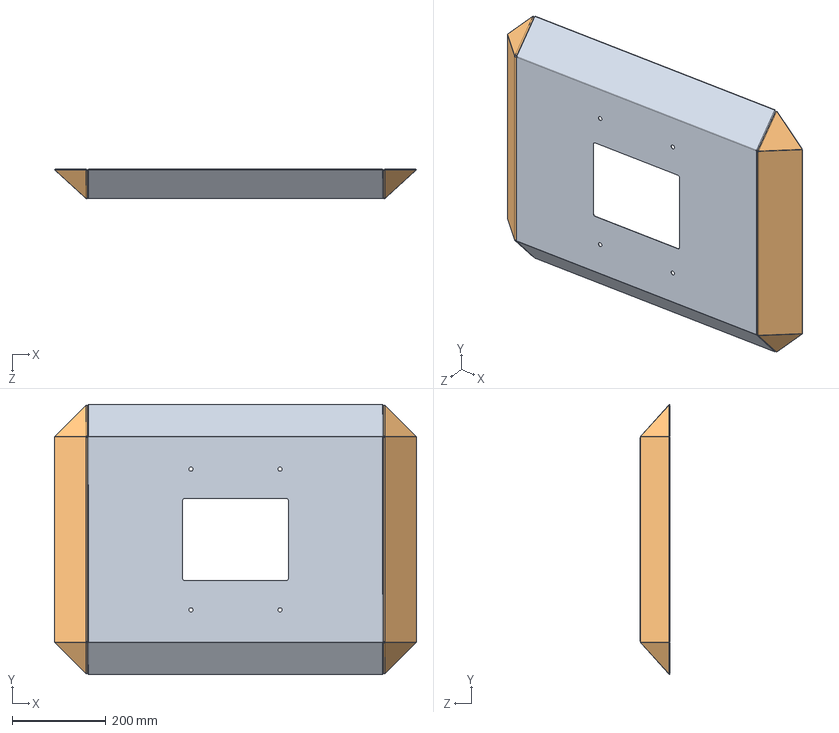
[picture p28: CAD file, 2026-07-09]
mechanical/cad/production_files/MMP.01.00.00.000 Cover assembly.STEP
771.6 x 575.6 x 63.0 mm
MMP.01.00.00.001 Cover_00
MMP.01.00.00.002 Cover flange_00 x 2
Âèíò DIN 7985 (öèë.)_ISO 7045 - M3 x 8 - Z --- 8C x 10
Ãàéêà DIN 934_Hexagon Nut ISO - 4032 - M3 - D - C x 10
ﾘ琺矜 DIN 125_Washer DIN 125 - A 3.2 x 20
Øàéáà DIN 7980 (ïðóæèííàÿ)_˜ ©¡ 3 ƒŽ‘’ 6402-70 x 10
