openAMRobot/openamr-platform-hw/mechanical/cad/production_files/MMP.05.00.00.000 Support assembly.STEP

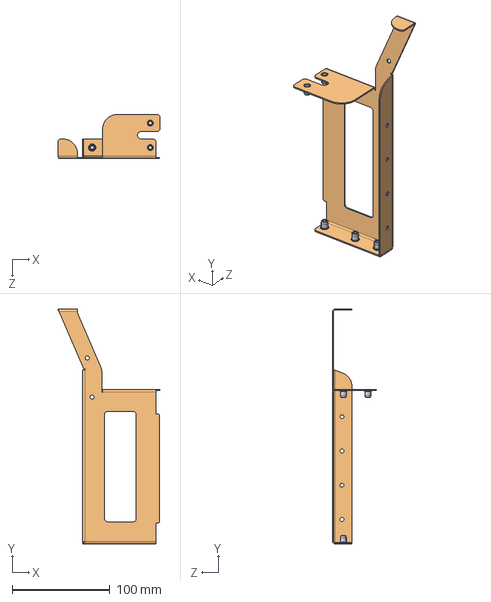
[picture p29: CAD file, 2026-07-09]
mechanical/cad/production_files/MMP.05.00.00.000 Support assembly.STEP
104.3 x 240.0 x 45.0 mm
Ãàéêà êëåïàëüíàÿ Ì4_0,5-2 óì. ïîòàé, ñòàëü_ãáâ.  1,2 ¬¬ x 5
MMP.05.00.00.001 Support_�� 㬮�砭��
