openAMRobot/openamr-platform-hw/mechanical/cad/production_files/MMP.04.00.00.000 Center bracket assembly.STEP

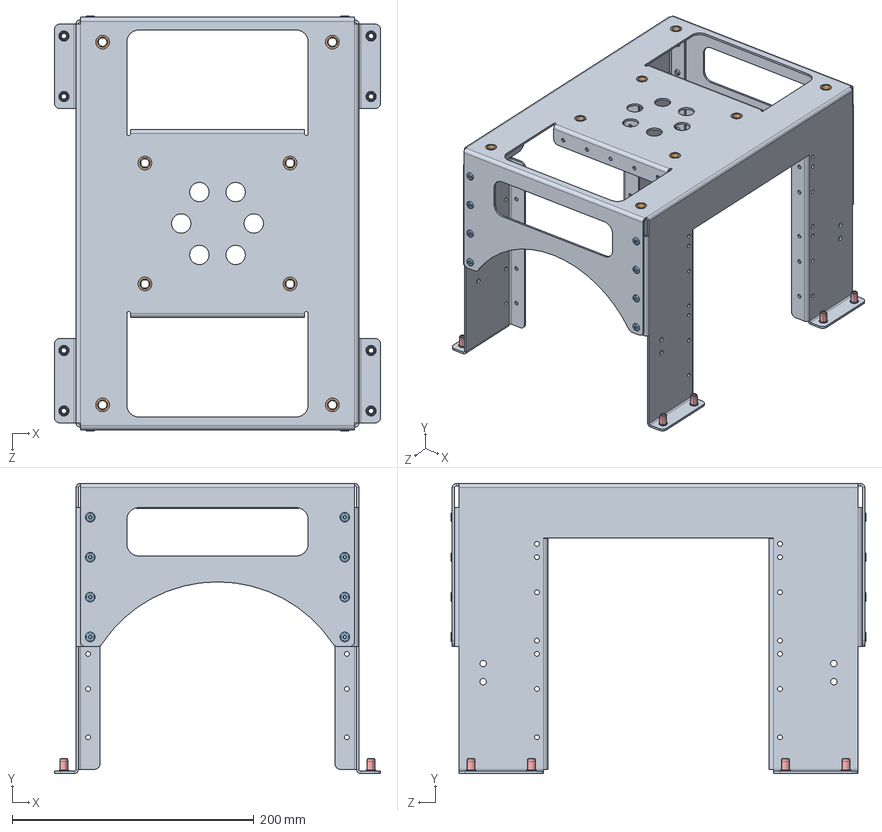
[picture p30: CAD file, 2026-07-09]
mechanical/cad/production_files/MMP.04.00.00.000 Center bracket assembly.STEP
270.0 x 240.0 x 343.2 mm
MMP.04.00.00.001 Center bracket_�� 㬮�砭��
Ãàéêà êëåïàëüíàÿ Ì8_0,5-2,5 óì. ïîòàé, ñòàëü_ãáâ.  2 ¬¬ x 8
Çàêë¸ïêà âûòÿæíàÿ 4,0 DIN 7337_ 4,1 x 16
Ãàéêà êëåïàëüíàÿ Ì5_0,5-2 óì. ïîòàé, ñòàëü_ãáâ.  2 ¬¬ x 8
