openAMRobot/openamr-platform-hw/mechanical/cad/production_files/MMP.03.00.00.000 Wheel assembly.SLDASM

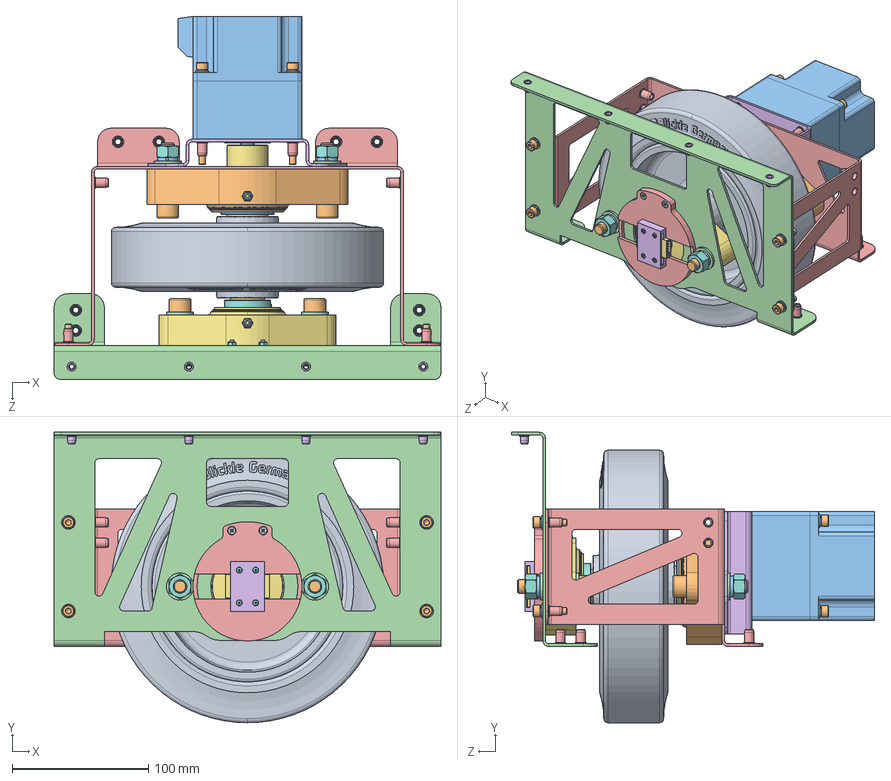
[picture p31: CAD file, 2026-07-09]
mechanical/cad/production_files/MMP.03.00.00.000 Wheel assembly.SLDASM
284.0 x 213.2 x 266.5 mm
GEVN_200_30H7_G15
РТ1.00.00.217 Шпонка
Шпонка 3-4x4x25 ГОСТ 23360-78
PT1.00.00.241 Adapter
PT1.00.00.242 Bracket
PT1.00.00.243 Cover
Плата магнитного энкодера
Винт М2-6gx8.48 DIN 7985 x 4
Гайка M2 DIN 934 x 4
Сердечник BMN-35H
Мотор-редуктор Z4BLD60-24GU серия 80
MMP.03.00.00.001 Wheel bracket outer
MMP.03.00.00.002 Wheel bracket inner
MMP.03.00.00.003 Motor bracket
MMP.03.00.00.004 Drive shaft
Гайка DIN 934 x 6
Винт DIN 965 (потай) x 2
Винт DIN 912 (вн. шест.) x 12
Шайба DIN 7980 (пружинная) x 12
Шайба DIN 125 x 14
Гайка клепальная М5_0,5-2 ум. потай, сталь x 20
Гайка клепальная М4_0,5-2 ум. потай, сталь x 4
Rexnord-UCFL- SUCFL- HCFL- SHCFL-UCFL 205 C-68563_HUB
Rexnord-UCFL- SUCFL- HCFL- SHCFL-UCFL 205 C-68563_BEARING
Rexnord-UCFL- SUCFL- HCFL- SHCFL-UCFL 205 C-68563_NIPPLE
Rexnord-UCFL- SUCFL- HCFL- SHCFL-UCFL 206 C-68439_HUB
Rexnord-UCFL- SUCFL- HCFL- SHCFL-UCFL 206 C-68439_BEARING
Rexnord-UCFL- SUCFL- HCFL- SHCFL-UCFL 206 C-68439_NIPPLE
