openAMRobot/openamr-platform-hw/mechanical/cad/production_files/MMP.03.00.00.001 Wheel bracket outer.STEP

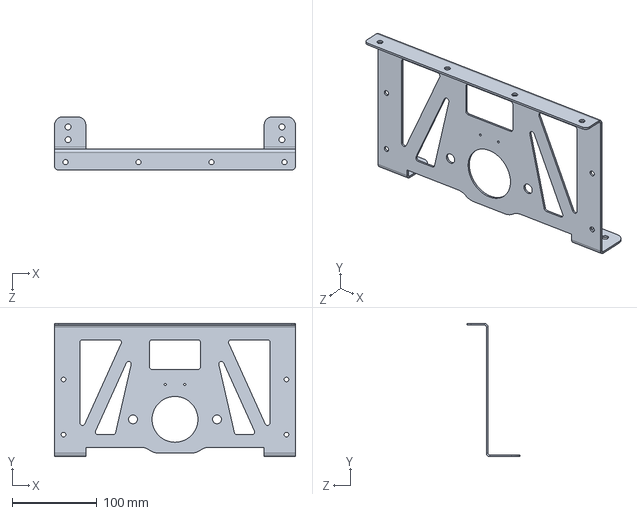
[picture p32: CAD file, 2026-07-09]
mechanical/cad/production_files/MMP.03.00.00.001 Wheel bracket outer.STEP
284.0 x 157.2 x 63.0 mm
