openAMRobot/openamr-platform-hw/mechanical/cad/production_files/MMP.00.00.00.002 Back panel.STEP

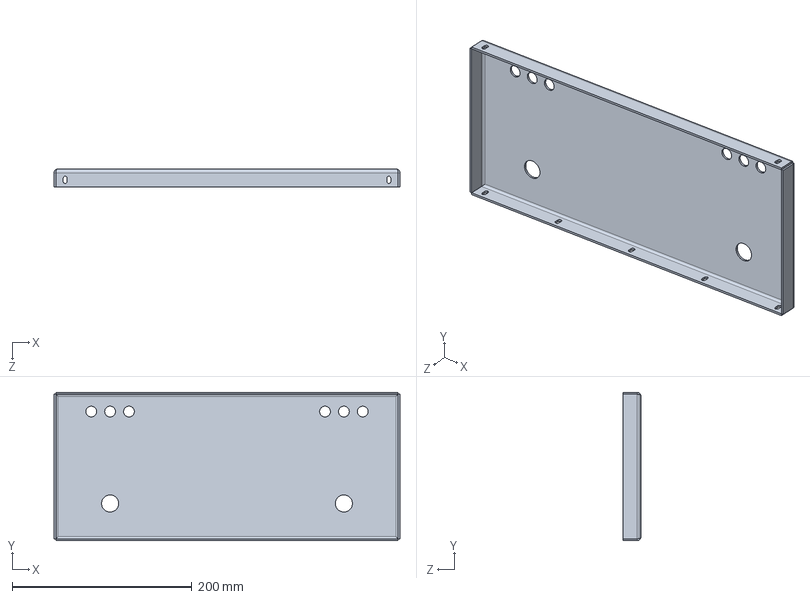
[picture p33: CAD file, 2026-07-09]
mechanical/cad/production_files/MMP.00.00.00.002 Back panel.STEP
384.8 x 165.0 x 20.0 mm
