openAMRobot/openamr-platform-hw/mechanical/cad/production_files/PT1.00.00.241 Adapter.STEP

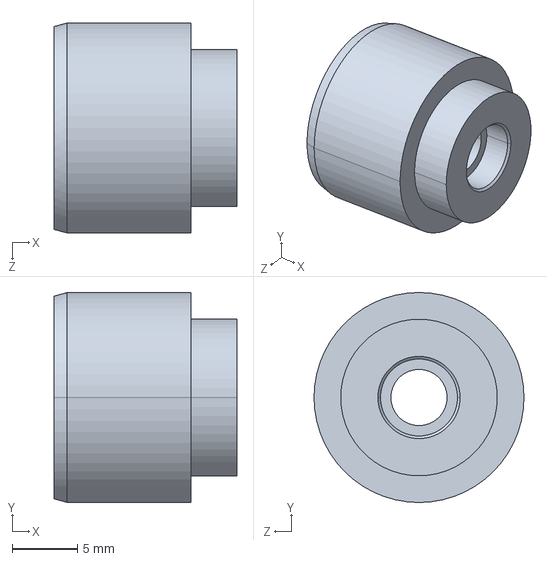
[picture p34: CAD file, 2026-07-09]
mechanical/cad/production_files/PT1.00.00.241 Adapter.STEP
14.0 x 16.1 x 16.1 mm
