openAMRobot/openamr-platform-hw/mechanical/cad/production_files/MMP.07.00.00.001 Lidar support.STEP

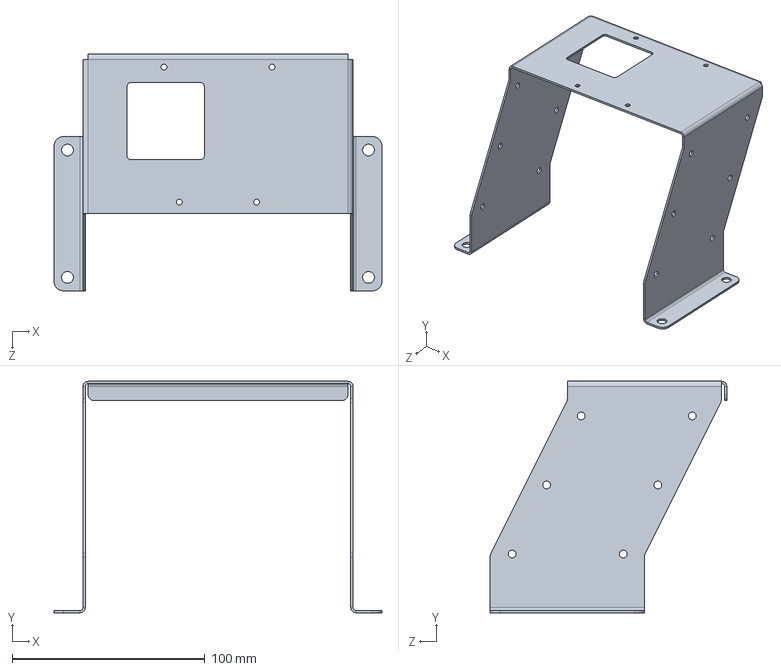
[picture p35: CAD file, 2026-07-09]
mechanical/cad/production_files/MMP.07.00.00.001 Lidar support.STEP
170.0 x 120.0 x 122.7 mm
