openAMRobot/openamr-platform-hw/mechanical/cad/production_files/MMP.05.00.00.001 Support.STEP

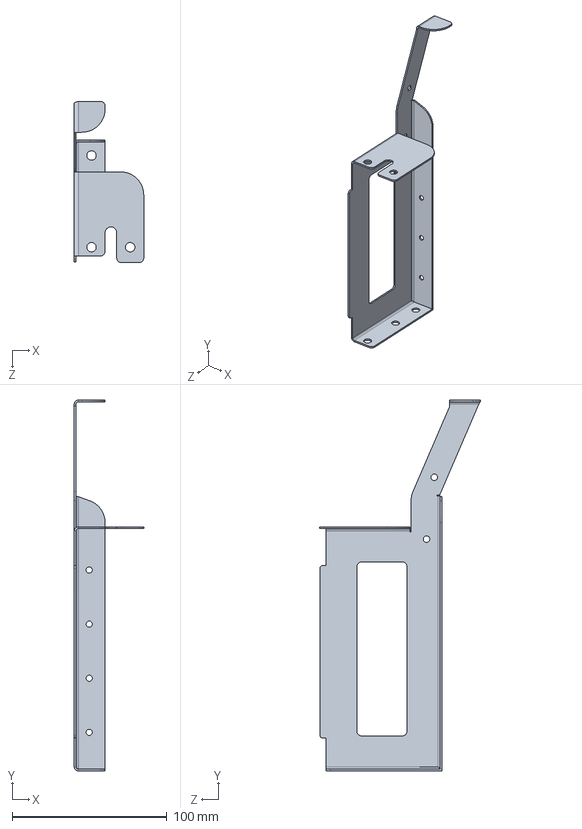
[picture p36: CAD file, 2026-07-09]
mechanical/cad/production_files/MMP.05.00.00.001 Support.STEP
45.0 x 240.0 x 104.3 mm
