openAMRobot/openamr-platform-hw/mechanical/cad/production_files/MMP.00.00.00.004 Plastic cover.STEP

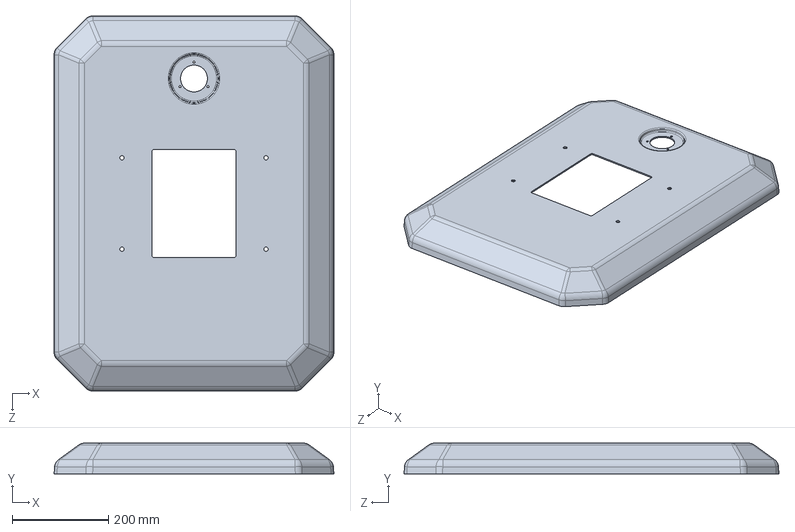
[picture p37: CAD file, 2026-07-09]
mechanical/cad/production_files/MMP.00.00.00.004 Plastic cover.STEP
582.0 x 64.0 x 780.0 mm
