openAMRobot/openamr-platform-hw/mechanical/cad/production_files/MMP.04.00.00.001 Center bracket.STEP

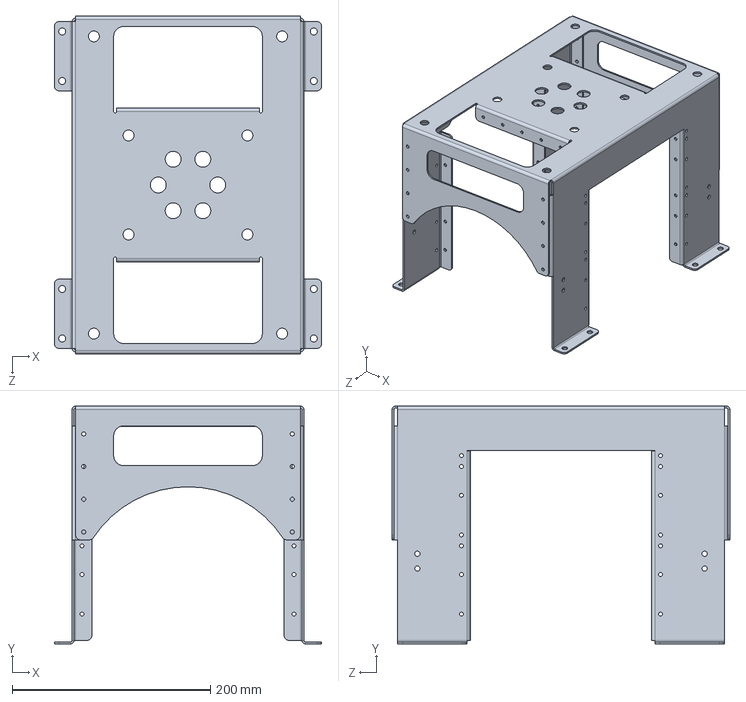
[picture p38: CAD file, 2026-07-09]
mechanical/cad/production_files/MMP.04.00.00.001 Center bracket.STEP
270.0 x 240.0 x 341.2 mm
