openAMRobot/openamr-platform-hw/mechanical/cad/production_files/PT1.00.00.243 Cover.STEP

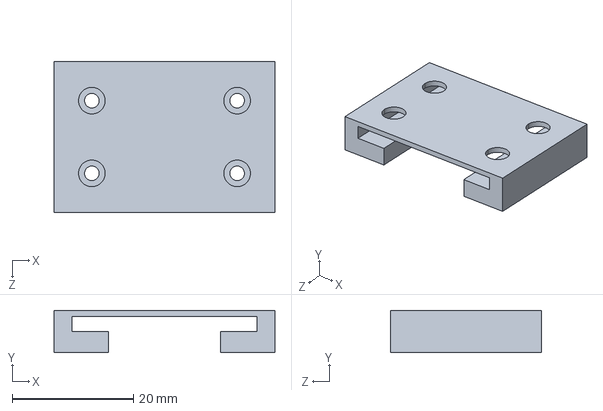
[picture p39: CAD file, 2026-07-09]
mechanical/cad/production_files/PT1.00.00.243 Cover.STEP
36.5 x 7.00 x 25.0 mm
