openAMRobot/openamr-platform-hw/mechanical/cad/production_files/MMP.03.00.00.004 Drive shaft.STEP

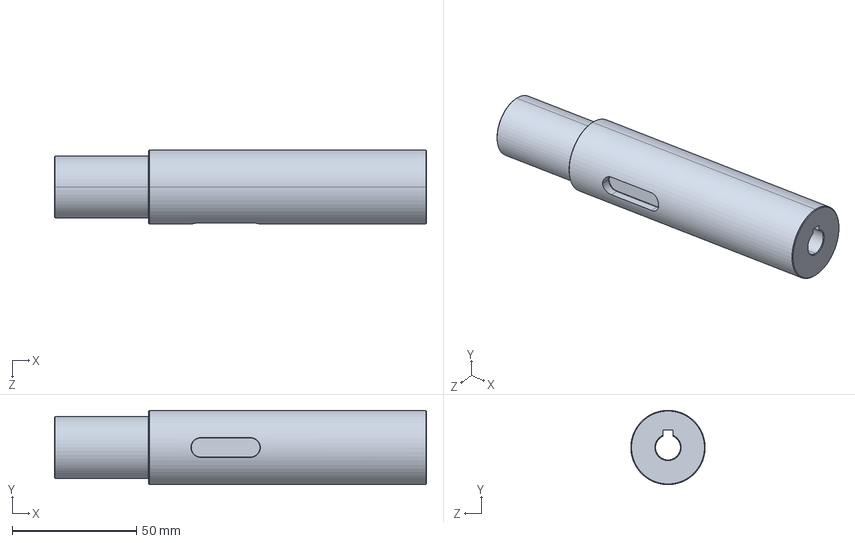
[picture p40: CAD file, 2026-07-09]
mechanical/cad/production_files/MMP.03.00.00.004 Drive shaft.STEP
150.0 x 30.0 x 30.0 mm
