openAMRobot/openamr-platform-hw/mechanical/cad/production_files/PT1.00.00.032 Camera upper body.STEP

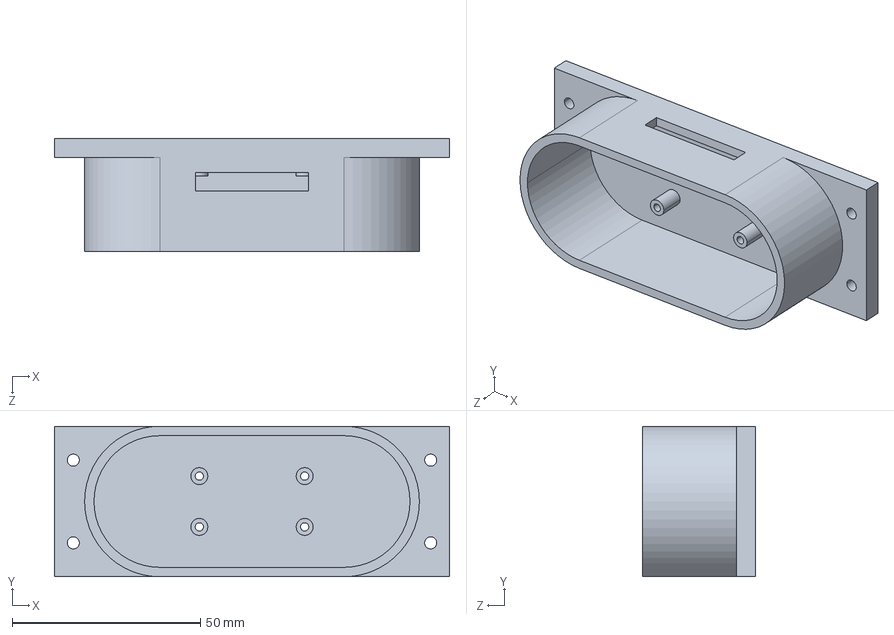
[picture p41: CAD file, 2026-07-09]
mechanical/cad/production_files/PT1.00.00.032 Camera upper body.STEP
105.0 x 40.0 x 30.0 mm
