openAMRobot/openamr-platform-hw/mechanical/cad/production_files/MMP.03.00.00.003 Motor bracket.STEP

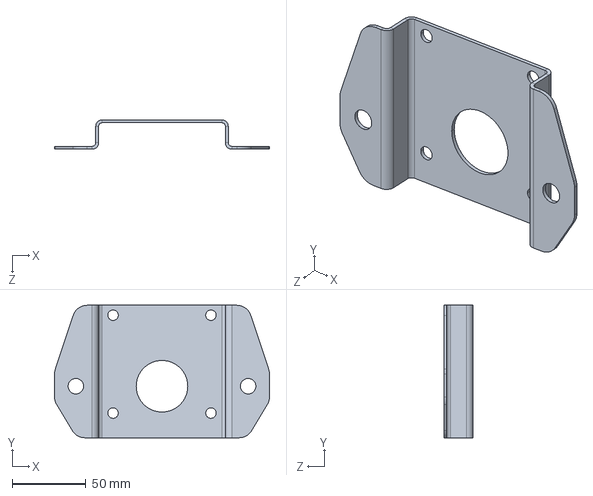
[picture p42: CAD file, 2026-07-09]
mechanical/cad/production_files/MMP.03.00.00.003 Motor bracket.STEP
146.0 x 90.0 x 20.0 mm
