openAMRobot/openamr-platform-hw/mechanical/cad/production_files/MMP.02.00.00.001 Base.STEP

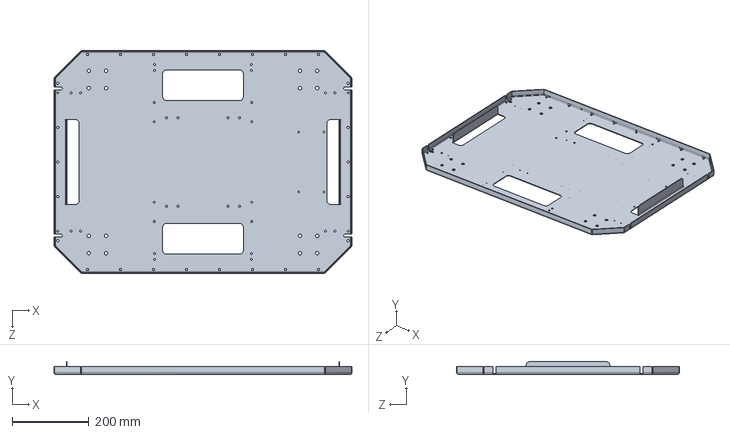
[picture p43: CAD file, 2026-07-09]
mechanical/cad/production_files/MMP.02.00.00.001 Base.STEP
776.0 x 32.9 x 580.0 mm
