openAMRobot/openamr-platform-hw/mechanical/cad/production_files/PT1.00.00.240 Magnetic encoder.STEP

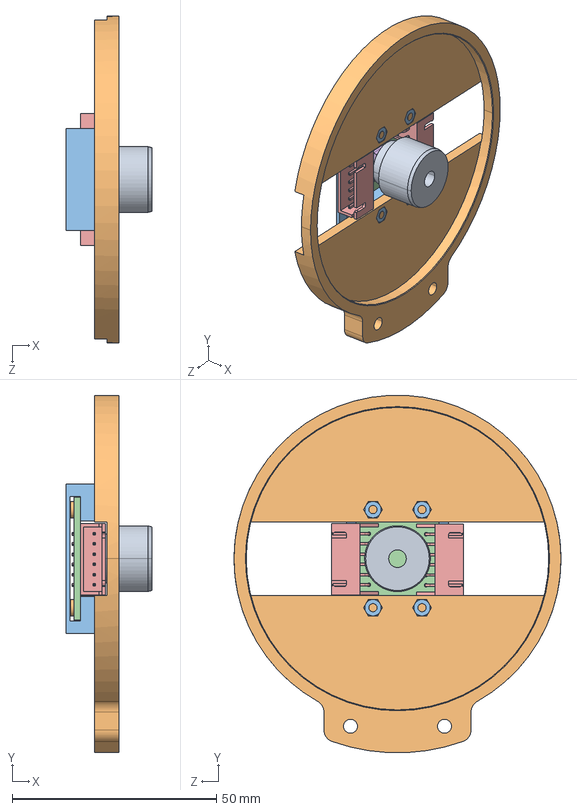
[picture p44: CAD file, 2026-07-09]
mechanical/cad/production_files/PT1.00.00.240 Magnetic encoder.STEP
21.0 x 87.4 x 80.0 mm
PT1.00.00.241 Adapter_00
PT1.00.00.242 Bracket_00
PT1.00.00.243 Cover_00
Ïëàòà ìàãíèòíîãî ýíêîäåðà_00
Âèíò Ì2-6gx8.48 DIN 7985_00 x 4
Ãàéêà M2 DIN 934_00 x 4
ﾑ褞蒟韭 BMN-35H_00
