openAMRobot/openamr-platform-hw/mechanical/cad/production_files/MMP.00.00.00.003 Side panel.STEP

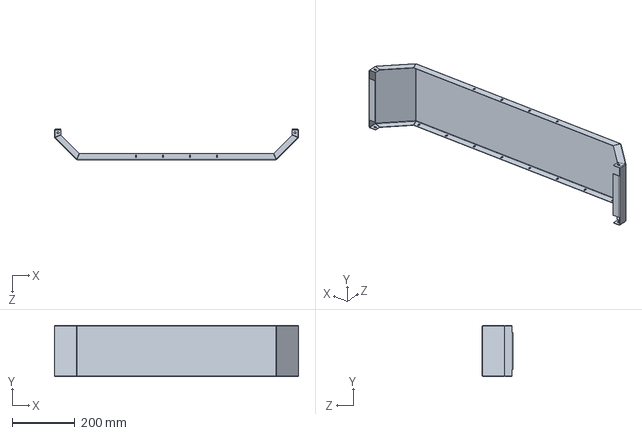
[picture p45: CAD file, 2026-07-09]
mechanical/cad/production_files/MMP.00.00.00.003 Side panel.STEP
778.6 x 163.0 x 97.5 mm
