openAMRobot/openamr-platform-hw/mechanical/cad/production_files/MMP.01.00.00.001 Cover.STEP

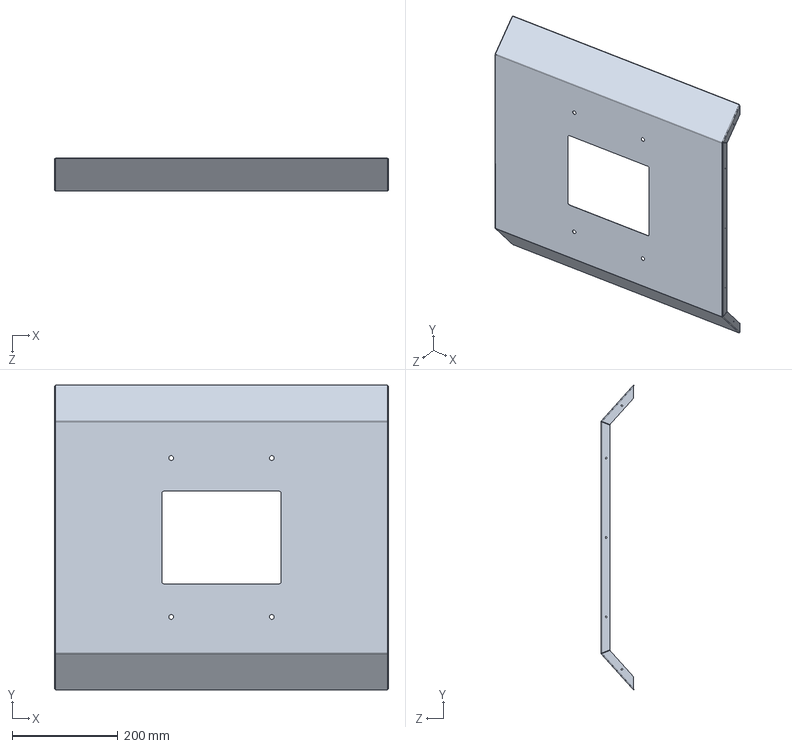
[picture p46: CAD file, 2026-07-09]
mechanical/cad/production_files/MMP.01.00.00.001 Cover.STEP
630.7 x 575.6 x 62.7 mm
