openAMRobot/openamr-platform-hw/mechanical/cad/production_files/PT1.00.00.242 Bracket.STEP

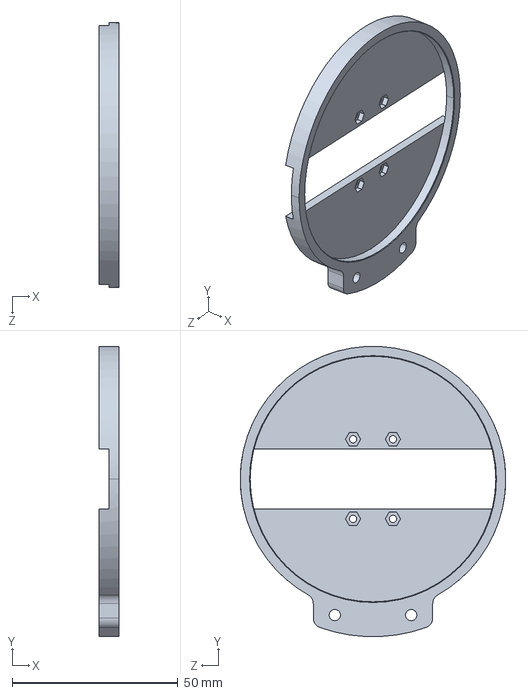
[picture p47: CAD file, 2026-07-09]
mechanical/cad/production_files/PT1.00.00.242 Bracket.STEP
6.00 x 87.4 x 80.0 mm
