openAMRobot/openamr-platform-hw/mechanical/cad/production_files/MMP.03.00.00.002 Wheel bracket inner.STEP

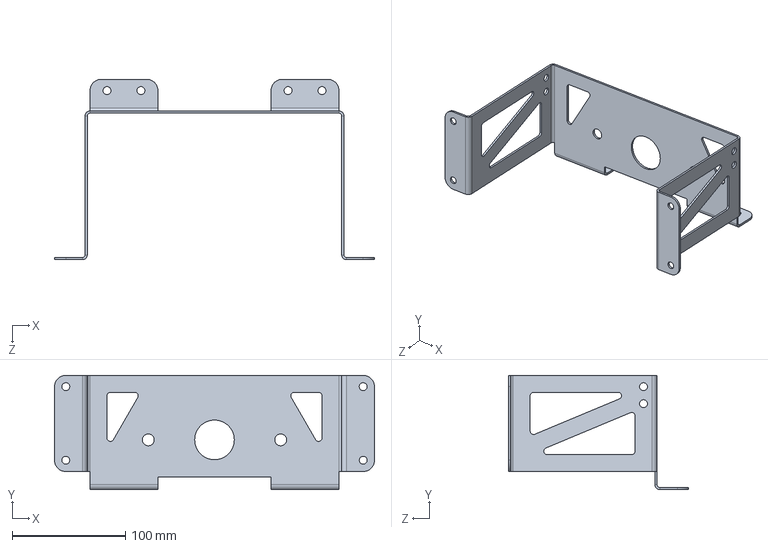
[picture p48: CAD file, 2026-07-09]
mechanical/cad/production_files/MMP.03.00.00.002 Wheel bracket inner.STEP
282.8 x 101.0 x 159.5 mm
