openAMRobot/openamr-platform-hw/mechanical/cad/production_files/MMP.01.00.00.002 Cover flange.STEP

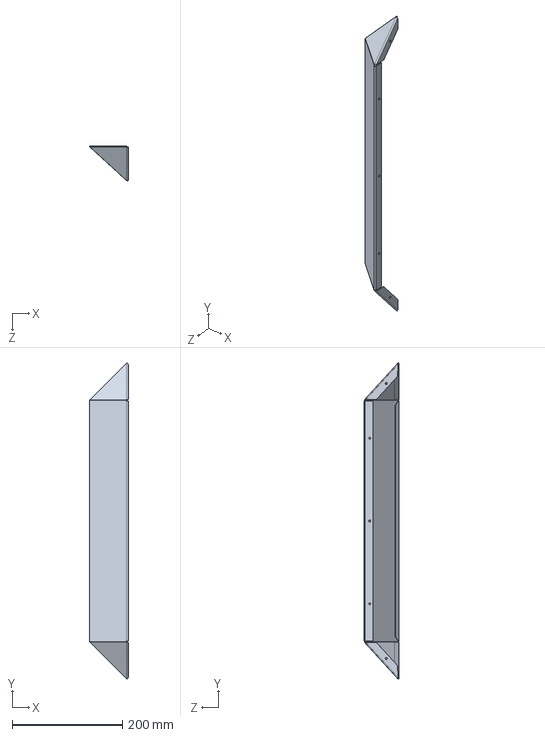
[picture p49: CAD file, 2026-07-09]
mechanical/cad/production_files/MMP.01.00.00.002 Cover flange.STEP
70.6 x 572.7 x 63.0 mm
