openAMRobot/openamr-platform-hw/(list of files, cad)

Other CAD files:
mechanical/cad/production_files/MMP.05.00.00.000-01 Support assembly.STEP
mechanical/cad/production_files/MMP.00.00.00.001 Front panel.STEP
mechanical/cad/production_files/MMP.05.00.00.001-01 Support.STEP
mechanical/cad/production_files/MMP.00.00.00.001 Front panel.DXF
mechanical/cad/production_files/MMP.00.00.00.001 Front panel.SLDDRW
mechanical/cad/production_files/MMP.00.00.00.001 Front panel.SLDPRT
mechanical/cad/production_files/MMP.00.00.00.002 Back panel.DXF
mechanical/cad/production_files/MMP.00.00.00.002 Back panel.SLDDRW
mechanical/cad/production_files/MMP.00.00.00.002 Back panel.SLDPRT
mechanical/cad/production_files/MMP.00.00.00.003 Side panel.DXF
mechanical/cad/production_files/MMP.00.00.00.003 Side panel.SLDDRW
mechanical/cad/production_files/MMP.00.00.00.003 Side panel.SLDPRT
mechanical/cad/production_files/MMP.00.00.00.004 Plastic cover.SLDPRT
mechanical/cad/production_files/MMP.01.00.00.000 Cover assembly.SLDASM
mechanical/cad/production_files/MMP.01.00.00.001 Cover.DXF
mechanical/cad/production_files/MMP.01.00.00.001 Cover.SLDDRW
mechanical/cad/production_files/MMP.01.00.00.001 Cover.SLDPRT
mechanical/cad/production_files/MMP.01.00.00.002 Cover flange.DXF
mechanical/cad/production_files/MMP.01.00.00.002 Cover flange.SLDDRW
mechanical/cad/production_files/MMP.01.00.00.002 Cover flange.SLDPRT
mechanical/cad/production_files/MMP.02.00.00.000 Base assembly.SLDASM
mechanical/cad/production_files/MMP.02.00.00.001 Base.DXF
mechanical/cad/production_files/MMP.02.00.00.001 Base.SLDDRW
mechanical/cad/production_files/MMP.02.00.00.001 Base.SLDPRT
mechanical/cad/production_files/MMP.03.00.00.001 Wheel bracket outer.DXF
mechanical/cad/production_files/MMP.03.00.00.001 Wheel bracket outer.SLDDRW
mechanical/cad/production_files/MMP.03.00.00.001 Wheel bracket outer.SLDPRT
mechanical/cad/production_files/MMP.03.00.00.002 Wheel bracket inner.DXF
mechanical/cad/production_files/MMP.03.00.00.002 Wheel bracket inner.SLDDRW
mechanical/cad/production_files/MMP.03.00.00.002 Wheel bracket inner.SLDPRT
mechanical/cad/production_files/MMP.03.00.00.003 Motor bracket.DXF
mechanical/cad/production_files/MMP.03.00.00.003 Motor bracket.SLDDRW
mechanical/cad/production_files/MMP.03.00.00.003 Motor bracket.SLDPRT
mechanical/cad/production_files/MMP.03.00.00.004 Drive shaft.SLDDRW
mechanical/cad/production_files/MMP.03.00.00.004 Drive shaft.SLDPRT
mechanical/cad/production_files/MMP.04.00.00.000 Center bracket assembly.SLDASM
mechanical/cad/production_files/MMP.04.00.00.001 Center bracket.DXF
mechanical/cad/production_files/MMP.04.00.00.001 Center bracket.SLDDRW
mechanical/cad/production_files/MMP.04.00.00.001 Center bracket.SLDPRT
mechanical/cad/production_files/MMP.05.00.00.000 Support assembly.SLDASM
mechanical/cad/production_files/MMP.05.00.00.001 Support.DXF
mechanical/cad/production_files/MMP.05.00.00.001 Support.SLDDRW
mechanical/cad/production_files/MMP.05.00.00.001 Support.SLDPRT
mechanical/cad/production_files/MMP.07.00.00.000 Lidar support assembly.SLDASM
mechanical/cad/production_files/MMP.07.00.00.001 Lidar support.DXF
mechanical/cad/production_files/MMP.07.00.00.001 Lidar support.SLDDRW
mechanical/cad/production_files/MMP.07.00.00.001 Lidar support.SLDPRT
mechanical/cad/production_files/PT1.00.00.032 Camera upper body.SLDPRT
mechanical/cad/production_files/PT1.00.00.240 Magnetic encoder.SLDASM
mechanical/cad/production_files/PT1.00.00.241 Adapter.SLDPRT
mechanical/cad/production_files/PT1.00.00.242 Bracket.SLDPRT
mechanical/cad/production_files/PT1.00.00.243 Cover.SLDPRT
