openAMRobot/openamr-platform-hw/manufacturing/assembly/README.md

# Assembly

## 🔩 Wheel Assembly Tutorial

Wheel Assembly (https://youtu.be/FlsYwoiEAsk?list=PLlQYRQ1Q-yzqA89n-1vjrnNSw8hSucCKi)

▶️ Step-by-step assembly of the OpenAMRobot drive wheel module.

The drive-wheel assembly (motor + gearbox + drive shaft + brackets, `MMP.03.*` in
[../../mechanical/](../../mechanical/)) is assembled in the sequence shown below. Follow the same
order left and right.

**Step 1**
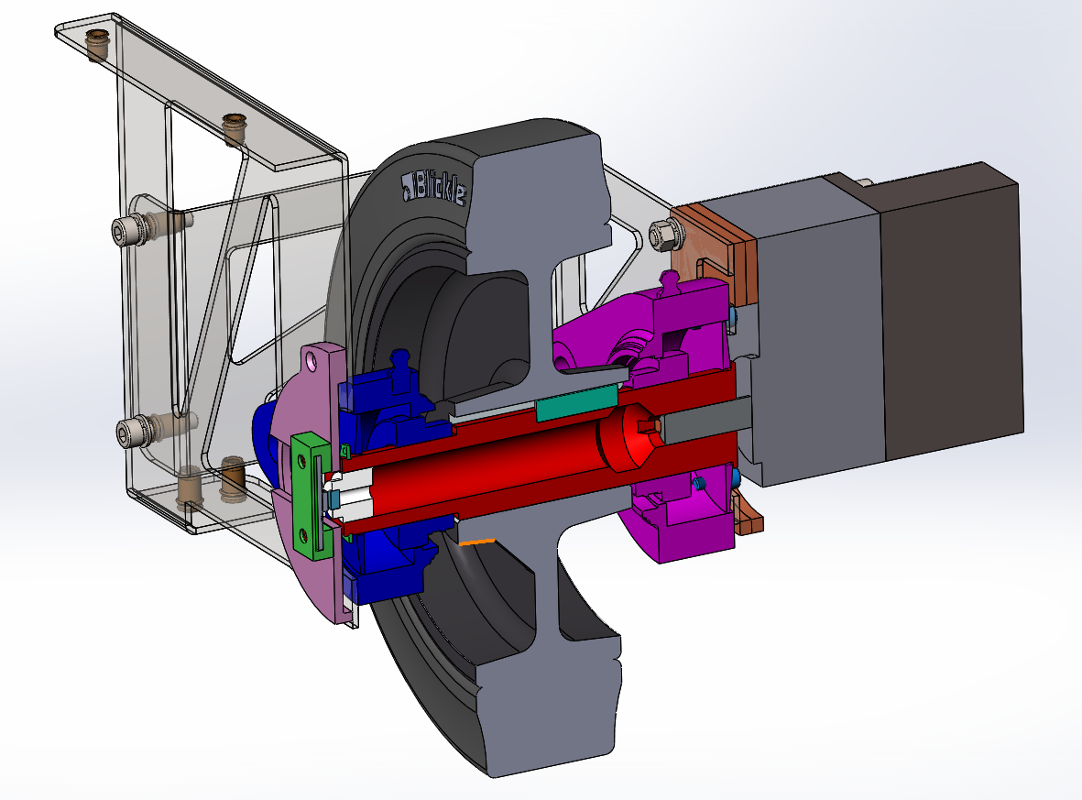
[picture p50: manufacturing/assembly/AMR_wheel_assembly_1.png]
Wheel assembly step 1


**Step 2**
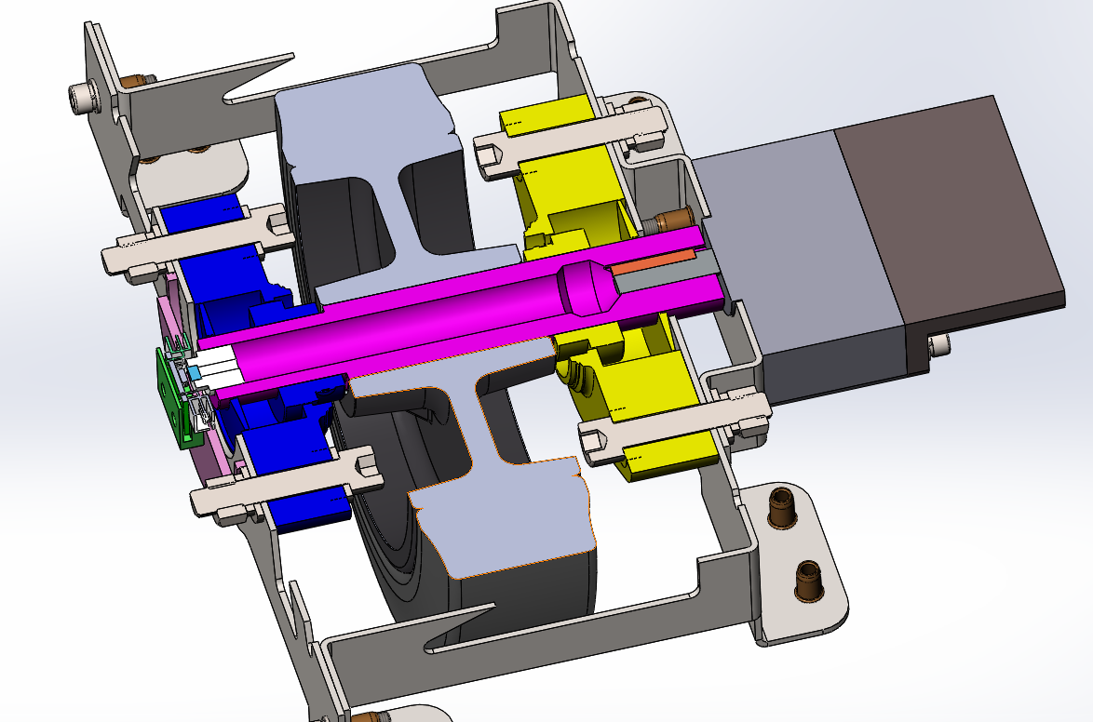
[picture p51: manufacturing/assembly/AMR_wheel_assembly_2.png]
Wheel assembly step 2


**Step 3**
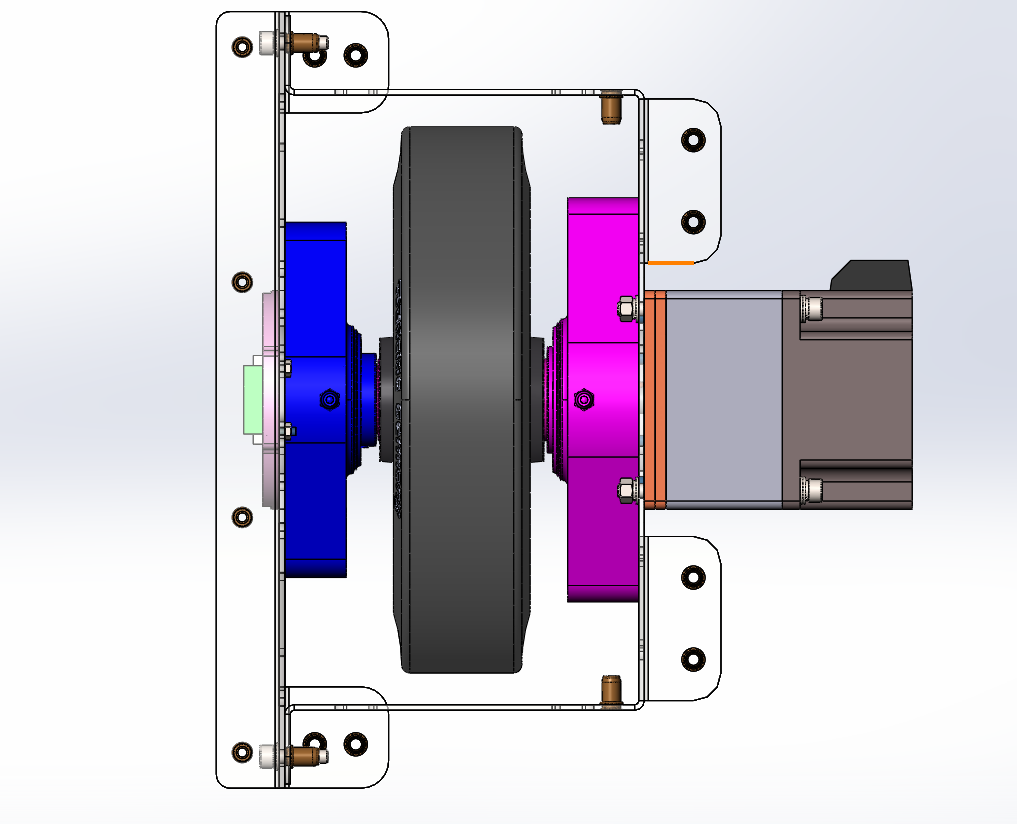
[picture p52: manufacturing/assembly/AMR_wheel_assembly_3.png]
Wheel assembly step 3


**Step 4**
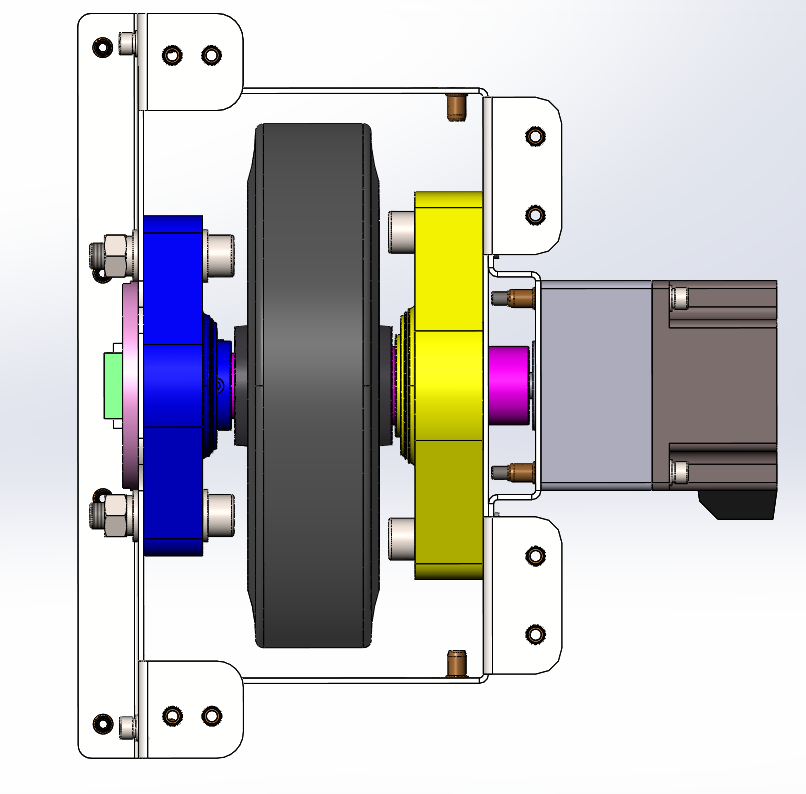
[picture p53: manufacturing/assembly/AMR_wheel_assembly_4.png]
Wheel assembly step 4


**Step 5**
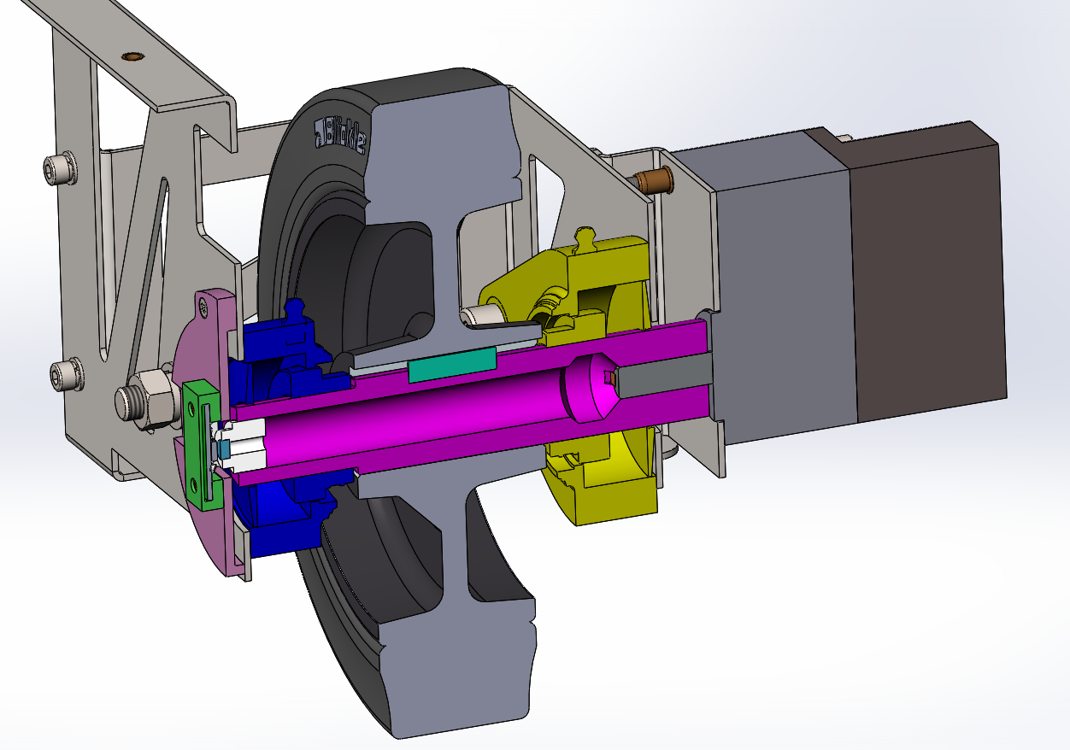
[picture p54: manufacturing/assembly/AMR_wheel_assembly_5.png]
Wheel assembly step 5


See the per-part production drawings (PDF/DXF) in
[../../mechanical/cad/production_files/](../../mechanical/cad/production_files/).
