openAMRobot/openamr-platform-hw/mechanical/cad/production_files/MMP.03.00.00.002 Wheel bracket inner.PDF

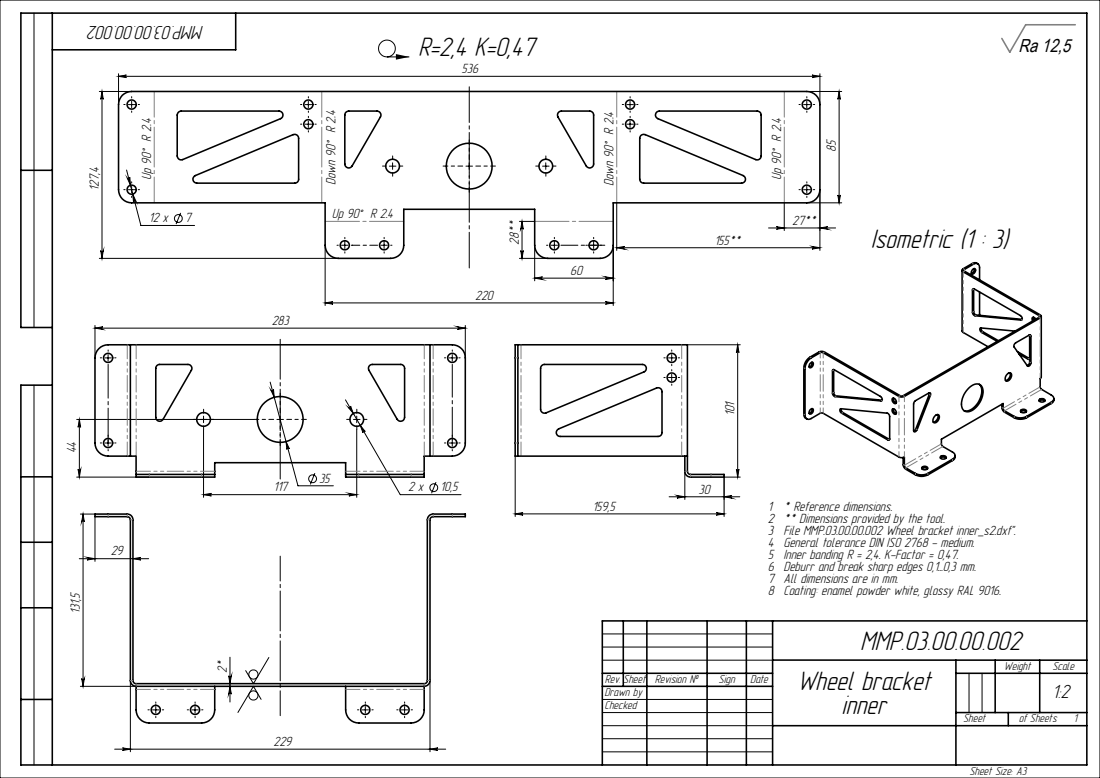
[picture p56: page 1]
Down 90° R 2.4; Isometric (1 : 3); Sheet Size: А3

1 * Reference dimensions.
2 ** Dimensions provided by the tool.
3 File MMP.03.00.00.002 Wheel bracket inner_s2.dxf".
4 General tolerance DIN ISO 2768 - medium.
5 Inner banding R = 2,4. K-Factor = 0,47.
6 Deburr and break sharp edges 0,1...0,3 mm.
7 All dimensions are in mm.
8 Coating: enamel powder white, glossy RAL 9016.

MMP.03.00.00.002

Wheel bracket | Weight | Scale

Rev. Sheet Revision № | | Sign | Date | | | | 1:2 inner
Drawn by
Checked

Sheet | of Sheets 1
