openAMRobot/openamr-platform-hw/mechanical/cad/production_files/MMP.04.00.00.001 Center bracket.PDF

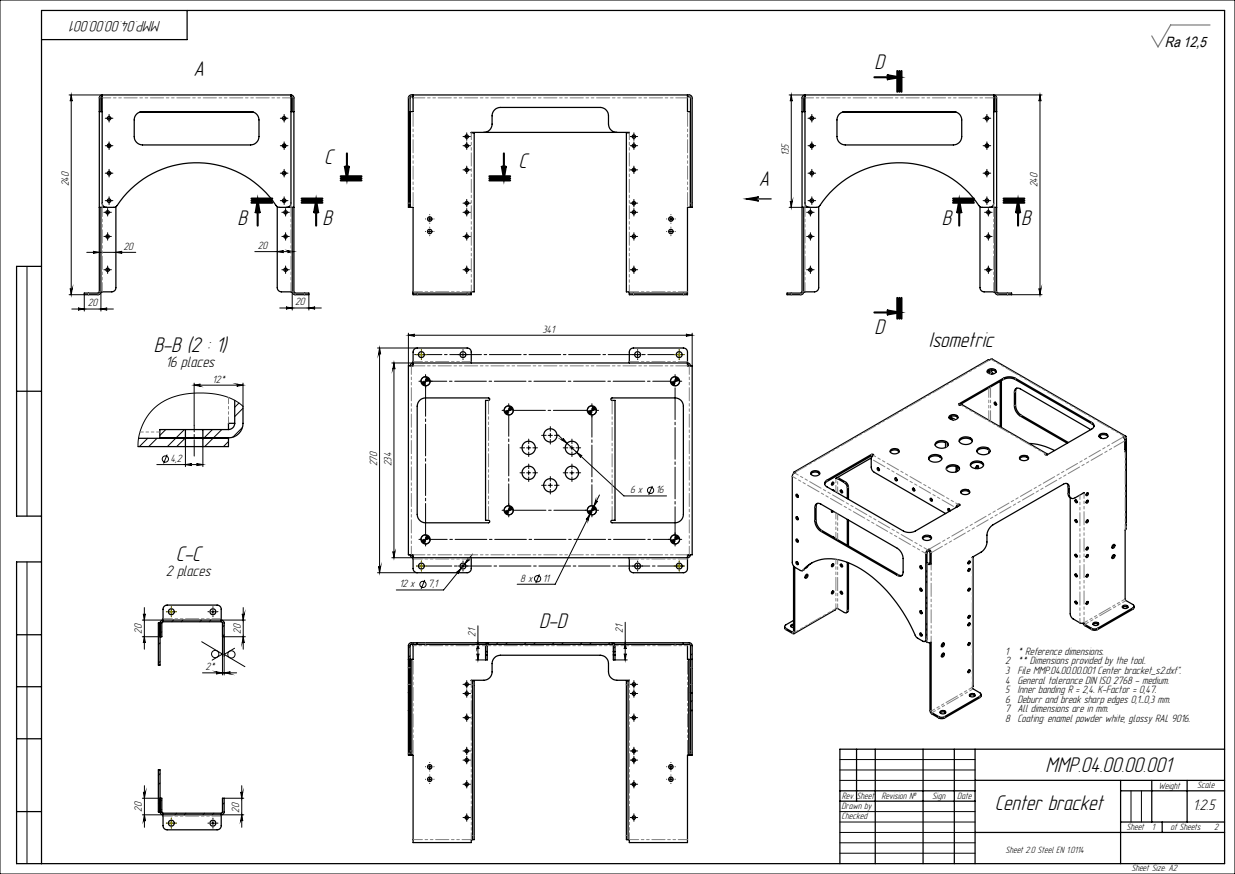
[picture p57: page 1]
B-B (2 : 1) 16 places; 2 places; Sheet Size: A2

1 * Reference dimensions.
2 ** Dimensions provided by the tool.
3 File MMP.04.00.00.001 Center bracket_s2.dxf".
4 General tolerance DIN ISO 2768 - medium.
5 Inner banding R = 2,4. K-Factor = 0,47.
6 Deburr and break sharp edges 0,1...0,3 mm.
7 All dimensions are in mm.
8 Coating: enamel powder white, glossy RAL 9016.

MMP.04.00.00.001

Center bracket | Weight | Scale

Rev. Sheet Revision № | | Sign | Date | | | | 1:2.5
Drawn by
Checked

Sheet 1 | of Sheets 2

Sheet 2.0 Steel EN 1.0114

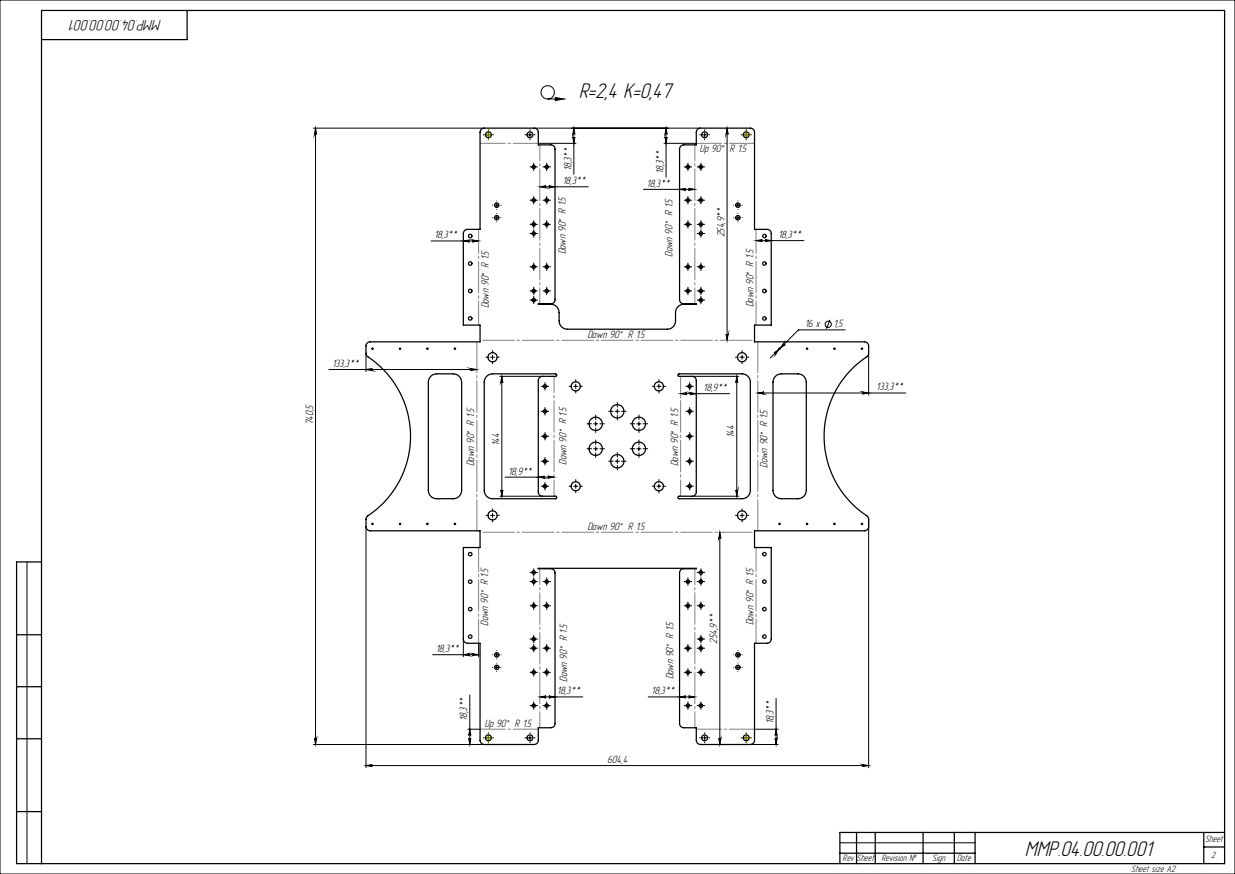
[picture p58: page 2]
Down 90° R 1.5; Down 90° R 1.5 Down 90° R 1.5; Rev Sheet Revision №; Sign; Date; Sheet size А2
