openAMRobot/openamr-platform-hw/mechanical/cad/production_files/MMP.07.00.00.001 Lidar support.PDF

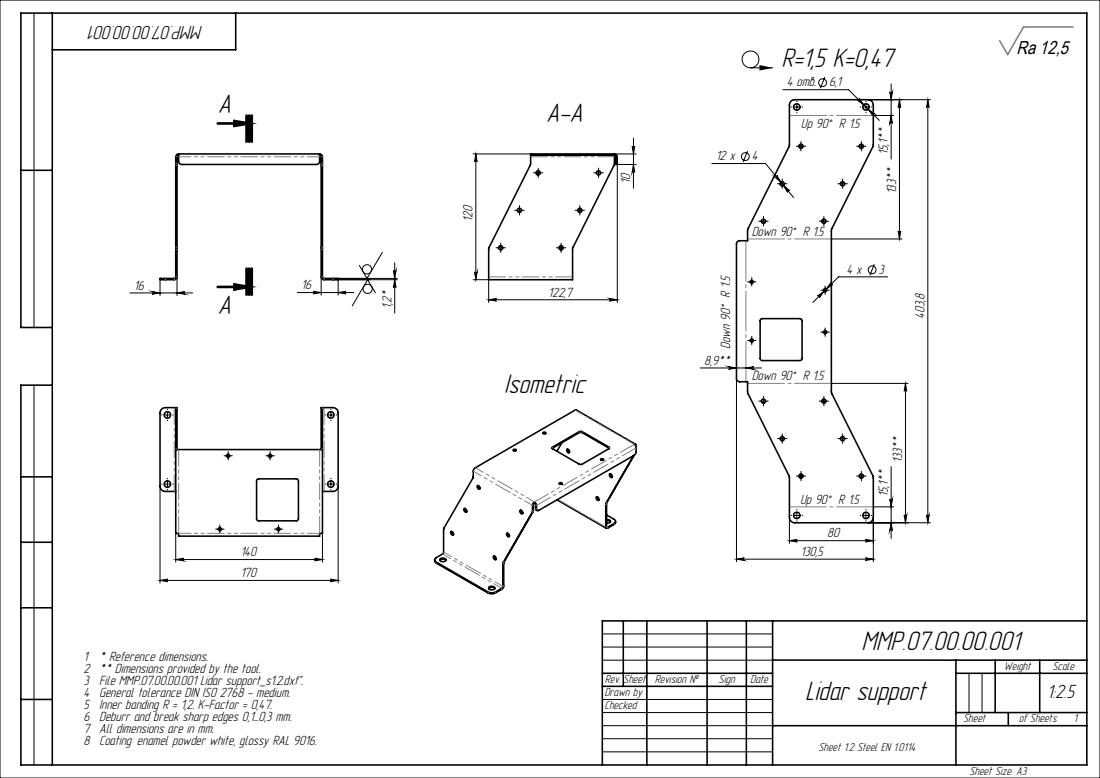
[picture p59: page 1]
4 îòâ. 6,1; Down 90° R 1.5; Sheet Size: А3

MMP.07.00.00.001

1 * Reference dimensions.
2 ** Dimensions provided by the tool.
3 File MMP.07.00.00.001 Lidar support_s1.2.dxf".
4 General tolerance DIN ISO 2768 - medium.
5 Inner banding R = 1,2. K-Factor = 0,47.
6 Deburr and break sharp edges 0,1...0,3 mm.
7 All dimensions are in mm.
8 Coating: enamel powder white, glossy RAL 9016.

Lidar support | Weight | Scale

Rev. Sheet Revision № | | Sign | Date | | | | 1:2.5
Drawn by
Checked

Sheet | of Sheets 1

Sheet 1.2 Steel EN 1.0114
