openAMRobot/openamr-platform-hw/mechanical/cad/production_files/MMP.00.00.00.001 Front panel.PDF

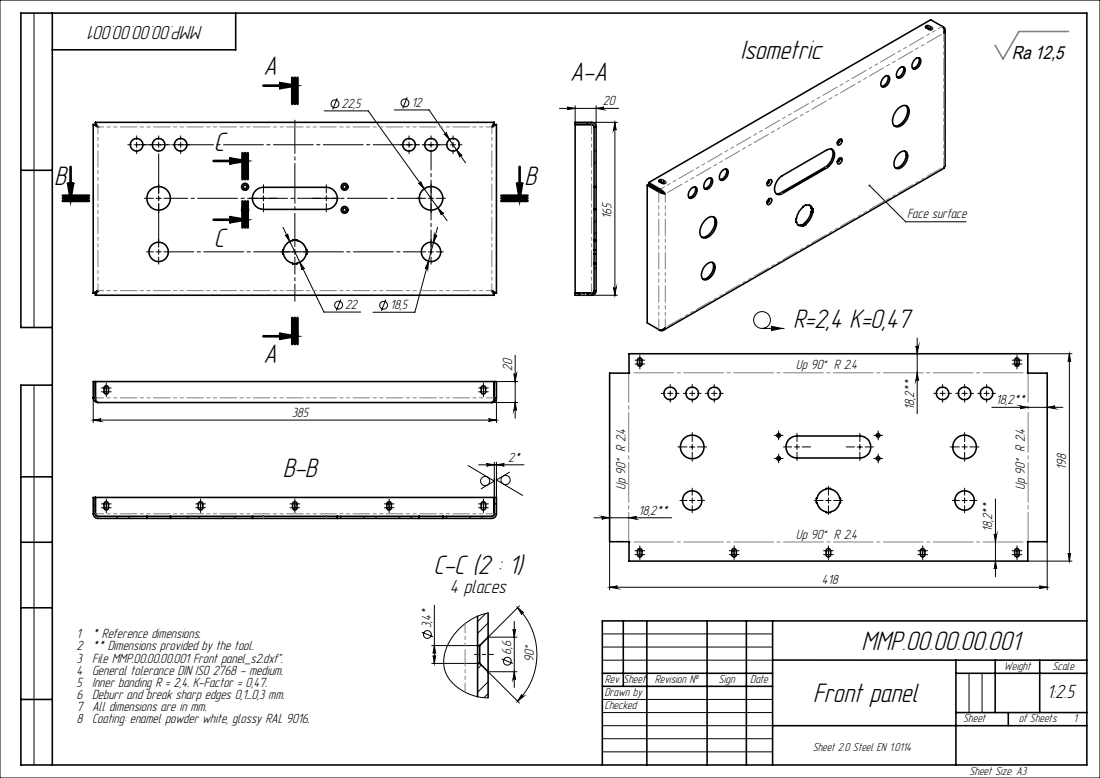
[picture p60: page 1]
Face surface; C-C (2 : 1) 4 places; Sheet Size: А3

MMP.00.00.00.001

1 * Reference dimensions.
2 ** Dimensions provided by the tool.
3 File MMP.00.00.00.001 Front panel_s2.dxf".
4 General tolerance DIN ISO 2768 - medium.
5 Inner banding R = 2,4. K-Factor = 0,47.
6 Deburr and break sharp edges 0,1...0,3 mm.
7 All dimensions are in mm.
8 Coating: enamel powder white, glossy RAL 9016.

Front panel | Weight | Scale

Rev. Sheet Revision № | | Sign | Date | | | | 1:2.5
Drawn by
Checked

Sheet | of Sheets 1

Sheet 2.0 Steel EN 1.0114
