openAMRobot/openamr-platform-hw/mechanical/cad/production_files/MMP.00.00.00.003 Side panel.PDF

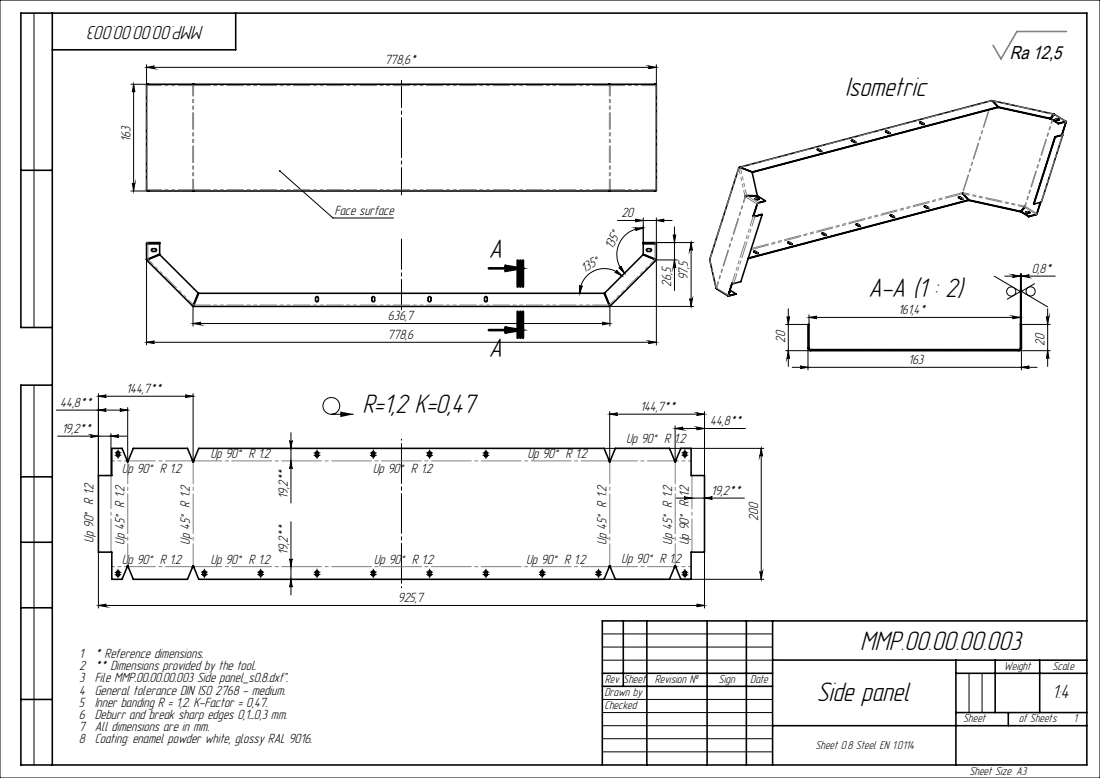
[picture p61: page 1]
Sheet Size: А3

Face surface | 20

MMP.00.00.00.003

1 * Reference dimensions.
2 ** Dimensions provided by the tool.
3 File MMP.00.00.00.003 Side panel_s0.8.dxf".
4 General tolerance DIN ISO 2768 - medium.
5 Inner banding R = 1,2. K-Factor = 0,47.
6 Deburr and break sharp edges 0,1...0,3 mm.
7 All dimensions are in mm.
8 Coating: enamel powder white, glossy RAL 9016.

Side panel | Weight | Scale

Rev. Sheet Revision № | | Sign | Date | | | | 1:4
Drawn by
Checked

Sheet | of Sheets 1

Sheet 0.8 Steel EN 1.0114
