openAMRobot/openamr-platform-hw/mechanical/cad/production_files/MMP.01.00.00.001 Cover.PDF

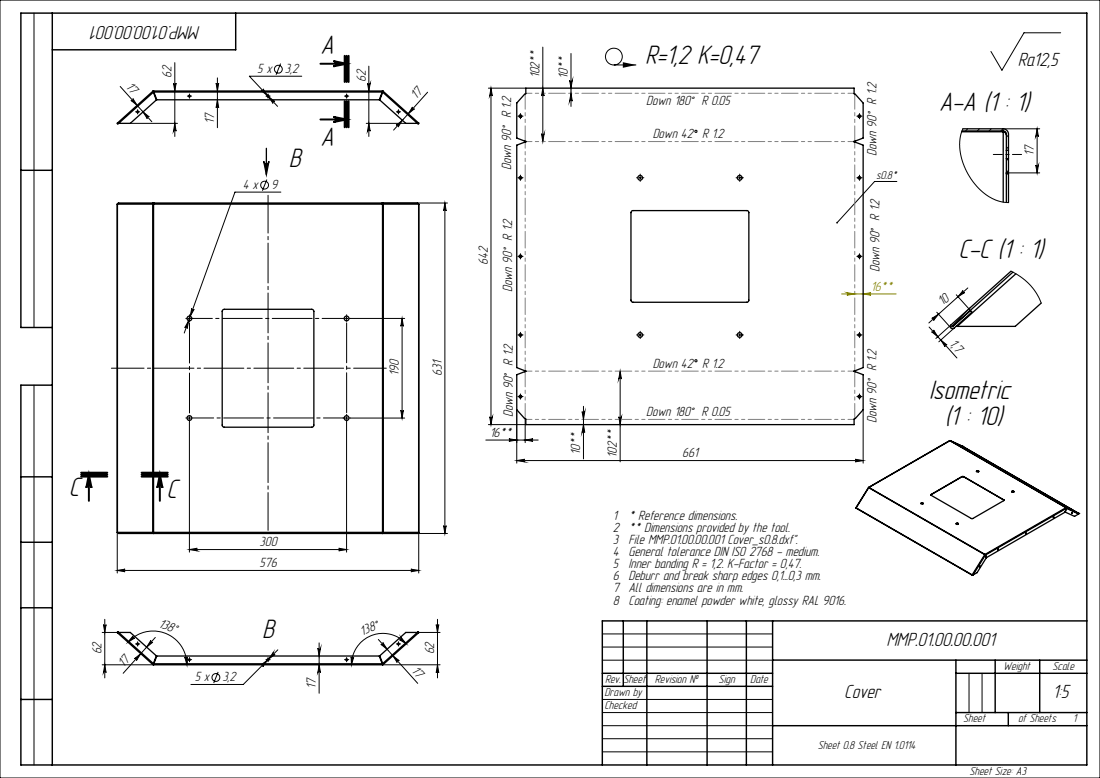
[picture p62: page 1]
Down 42 R 1.2; Down 180° R 0.05; Sheet Size: À3

Down 90° R 1.2 Down 90° R 1.2 Down 90° R 1.2

1 * Reference dimensions.
2 ** Dimensions provided by the tool.
3 File MMP.01.00.00.001 Cover_s0.8.dxf".
4 General tolerance DIN ISO 2768 - medium.
5 Inner banding R = 1,2. K-Factor = 0,47.
6 Deburr and break sharp edges 0,1...0,3 mm.
7 All dimensions are in mm.
8 Coating: enamel powder white, glossy RAL 9016.

MMP.01.00.00.001

Cover | Weight | Scale

Rev. Sheet Revision ¹ | | Sign | Date | | | | 1:5
Drawn by
Checked

Sheet | of Sheets 1

Sheet 0.8 Steel EN 1.0114
