openAMRobot/openamr-platform-hw/mechanical/cad/production_files/MMP.05.00.00.001 Support.PDF

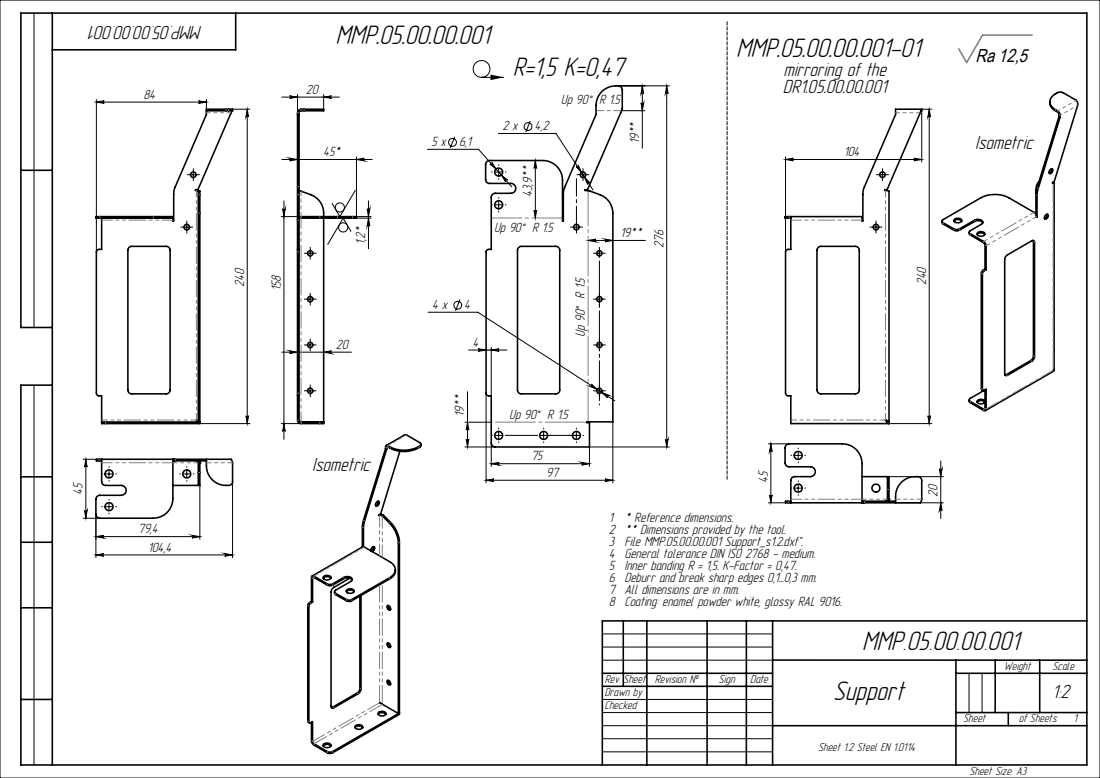
[picture p64: page 1]
Sheet Size: А3

mirroring of the

1 * Reference dimensions.
2 ** Dimensions provided by the tool.
3 File MMP.05.00.00.001 Support_s1.2.dxf".
4 General tolerance DIN ISO 2768 - medium.
5 Inner banding R = 1,5. K-Factor = 0,47.
6 Deburr and break sharp edges 0,1...0,3 mm.
7 All dimensions are in mm.
8 Coating: enamel powder white, glossy RAL 9016.

MMP.05.00.00.001

Support | Weight | Scale

Rev. Sheet Revision № | | Sign | Date | | | | 1:2
Drawn by
Checked

Sheet | of Sheets 1

Sheet 1.2 Steel EN 1.0114
