openAMRobot/openamr-platform-hw/(commit log)

2026-07-08 docs(hardware): real-robot hardware audit (BOM, wiring, power, sensors, safety)
    Per-component reference sheets from the real-robot audit, placed by domain: manufacturing/bom (BOM + datasheets), electrical/{wiring,motor_control,sensors,power_distribution,computing}, docs/safety. Cross-links fixed; cross-repo links noted as text.
2026-07-08 docs(computing,power): Pi 5 thermal throttling + brown-out + battery thresholds
    No active cooler -> 83.4 C, throttled=0x80008 soft thermal limit engaged, clock
    capped ~2.1 GHz, slows nav; fix = official Pi 5 Active Cooler. Add the 5 V/5 A
    bring-up brown-out (power, not heat). Translate battery-threshold section to
    English. Reconcile RAM 4 GB (old board) -> 8 GB (2026-07-06 hardware swap).
2026-07-08 docs(motor_control): ZBLD LED fault-code reference + measured velocity floors
    Add the missing ZBLD.C20 fault-code doc (code = green x5 + red; 10 = under-
    voltage, 14 = locked rotor). Add measured low-speed floors (linear 0.04-0.05,
    angular 0.15) — motor is well-sized; floors are stick-slip + coarse Hall.
2026-07-08 docs(sensors,wiring): encoder velocity-error profile + DC wire colours
    Residual encoder eccentricity: LEFT +/-11%, RIGHT +/-6%, speed-independent;
    averages to 1.0/rev (no odometry drift), only intra-rev ripple; durable fix =
    velocity filter, not a runtime table (incremental encoder loses phase at boot).
    Document the DC power wire colours (brown=+, blue=-).
2026-07-08 docs(hw): audit fixes — 3.3V rail, encoder fix framing, DIP/RAM, fault codes, mechanical dims
    Apply the hardware docs audit: IMU+encoders on 3.3 V (not 5 V, post 2026-06-19
    fix) in power.md + encoders.md; reframe the encoder ripple fix as the deployed
    hot-loaded table + per-boot align_enc_cal.py (velocity filter was rejected),
    labelling +/-11%/6% as table-not-loaded residual; DIP SW4/SW5 = ON/ON (5 pole
    pairs); RAM = 8 GB confirmed; disambiguate the ZBLD LED fault-code reading (drop
    the aliased row, field-confirmed 10=1g5r/14=2g4r); add drivetrain dimensions
    (wheel radius 0.046533 m, track 0.4075 m); camera example -> 1280x720 bgr8;
    PWM 3 kHz; translate French to English; fix dangling cros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
2026-07-08 docs+licensing: release-readiness pass (license, meta, README, geometry fix)
    Licensing (release blocker):
    - LICENSE: real MIT text (c) 2026 OpenAMRobot for the docs/BOM (was a
    "terms defined later" placeholder), with the CERN-OHL-S-2.0 intent kept for
    future hardware design files.
    - Filled NOTICE, AUTHORS, CHANGELOG, SECURITY, CONTRIBUTING (were 0 bytes).
    Geometry correction (my earlier audit error):
    - BOM drivetrain: the wheel was listed as radius 0.046533 m "measured on the
    real robot" — that was WRONG (0.046533 is the CAD-exported wheel axle height,
    mis-propagated into robot.sdf's wheel_radius). Corrected to the firmware-measured
    wheel ⌀ 0.2 m / track 0.46 m, recomputed max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
2026-07-08 docs: add diagram placeholders where they matter (wiring, power, control)
    Adds visible diagram placeholders (each with a ready-to-paste generation
    prompt) at the high-value spots, and references them in the text as if present.
    NOT decorative — only where a picture genuinely helps a builder:
    - wiring-pinout: system harness, Teensy pin map, driver connections, DIP switches
    - power: power-distribution diagram (24 V -> drivers, buck -> 5 V -> Pi, 3.3 V logic)
    - motors-drivers: the per-wheel control signal chain
    - encoders: AS5040 quadrature wiring on the 3.3 V rail
    - README: system block diagram
    Diagrams themselves to be generated from the embedded prompts.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
2026-07-08 docs(audit): fix broken cross-repo references + genericize unit serial
    Coherence audit fixes:
    - Replace the "filename.md (see openamr-platform-xx: ...)" placeholder-style
    cross-repo references (6 files) with clean references to the real target
    repos/docs — they read as unresolved TODOs otherwise.
    - Label the unit-specific Teensy USB serial (16778200) as a reference-unit
    value in teensy.md and raspberry-pi.md.
2026-07-08 docs(wiring): add the generated wiring-harness + Teensy-pinout diagrams
    Verified both SVGs against the firmware pin config and the hardware:
    - wiring-harness.svg: all blocks/rails correct (24 V/5 V/3.3 V domains,
    ZBLD drivers, Z4BLD60 motors, AS5040 3.3 V, MPU6500 0x68, RPLIDAR, Cam3,
    common-ground note, fuse + battery-disconnect marked NOT FITTED).
    - teensy-pinout.svg: all pins correct (SDA18/SCL19, enc 14/15 & 11/12,
    M1 PWM1/FWD20/REV21, M2 PWM5/FWD6/REV8, LED13), 3.3V-not-5V warning,
    pin-21-not-PWM gotcha.
    Replaced the two placeholders with the images; kept the generation prompt as
    an HTML comment for regeneration. Driver-connections + DIP diagrams still TODO.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
2026-07-08 docs(wiring): add the generated driver DIP-switch diagram (SW1..SW6 verified)
2026-07-08 docs(wiring/power): add power-distribution diagram + fix driver-terminal prompt
    - power.md: placed the verified power-distribution diagram (230 V charger ->
    24 V battery -> drivers + buck 5 V -> Pi, 3.3 V logic, fuse+disconnect NOT FITTED).
    - wiring-pinout.md: the driver-connections (Figure 3) prompt did not pin the
    terminal ORDER, so a generated diagram grouped the 4 wired terminals together
    instead of at their real positions. Rewrote the prompt to spell out the exact
    12-terminal order bottom->top (FWD/DI1, REV/DI2, JOG/DI3, CLR/DI4, BRK/DI5,
    COM, VAR/AI2, +5V, ERR/DO1, SPD/DO2, A+, B-) with the 4 wired at positions
    1/2/6/7 and English labels. (Diagram itself still to regenerate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
2026-07-08 docs: strip regeneration prompts from placed diagrams (were leaking on GitHub)
    The placement script left the harness + pinout regeneration prompts OUTSIDE a
    malformed empty HTML comment, so they showed as a visible blockquote on GitHub.
    Removed the prompt text from all placed diagrams (harness, pinout, DIP, power) —
    image only now; the prompts remain in git history and in the still-unplaced
    driver-connections placeholder.
2026-07-08 docs(wiring): update Teensy pinout diagram to v2 (fixed text overflow, verified pins/English)
2026-07-08 docs(wiring): add the ZBLD driver-connections diagram (v2, verified)
    Verified against the wiring table + firmware config: 12-position terminal block
    in the correct order 1(bottom)->12(top) (FWD/DI1, REV/DI2, JOG/DI3, CLR/DI4,
    BRK/DI5, COM, VAR/AI2, +5V, ERR/DO1, SPD/DO2, A+, B-), only 1/2/6/7 wired,
    Teensy links (PWM L1/R5, FWD L20/R6, REV L21/R8, GND->COM), 24 V screw terminals,
    8-pin motor Molex, internal Hall commutation. English throughout. Replaced the
    placeholder with the image (no prompt left behind). wiring-pinout.md now has all
    4 figures as images and zero residual prompts.
2026-07-08 docs(motor-control): add the per-wheel closed-loop signal-chain diagram (verified)
    Verified against the control design: /cmd_vel -> micro-ROS -> Teensy PID (closed
    loop) -> ZBLD driver (open loop, SW1 OFF, power stage + Hall commutation) -> BLDC
    -> ~30:1 gearbox -> wheel -> AS5040 encoder (wheel output, quadrature) back to the
    PID. Correctly states the speed loop is closed by the Teensy PID, not the driver.
    English throughout. Replaced the placeholder (no prompt left behind).
2026-07-08 docs(encoders): add the AS5040 encoder-wiring diagram (3.3 V, pins, quadrature — verified)
2026-07-08 docs(readme): add the system block diagram (verified) — HW diagrams complete
    Verified: four subsystems (Sensing/Compute/Actuation/Power), AS5040+MPU6500+
    RPLIDAR+Cam3 sensing, Teensy<->Pi5 compute over USB, Teensy->ZBLD->BLDC->wheels
    actuation, 24 V -> buck 5 V -> 3.3 V power, bus types labelled. English.
    All 8 hardware diagrams now placed; no generation prompts remain in the repo.
2026-07-08 docs: remove orphaned generation prompts left after the last 4 diagram placements
    The placement regex was non-greedy and stopped at the opening code fence, so the
    prompt body survived as a visible blockquote right after the image (driver
    connections, encoder wiring, motor signal chain, and the README system block).
    Removed all four; verified zero prompt artifacts remain in the HW repo and all 8
    diagram images are intact.
2026-07-08 refactor(structure): drop the redundant docs/ folder; make the layout coherent
    The near-empty docs/ (only docs/safety/safety.md + empty placeholder subdirs)
    overlapped confusingly with the real per-subsystem docs in electrical/ and
    manufacturing/. For a hardware repo, every top-level folder should be a hardware
    domain/concern:
    - Moved docs/safety/safety.md -> safety/ (new top-level, parallel to electrical/,
    mechanical/, manufacturing/); fixed its relative links.
    - Removed the docs/ folder and its empty architecture/assembly/troubleshooting
    placeholders (assembly duplicated manufacturing/assembly).
    - Removed 6 now-useless .gitkeep files from directories that already hold real
    files (ele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
2026-07-08 fix(diagrams): real white background — the previous 'white rect' was inside a mask
    5 of the 8 SVGs had their only white full-canvas <rect> INSIDE a <mask> in <defs>
    (a text-knockout mask), so it never painted — the background stayed transparent
    (shows dark on dark viewers). My earlier detection was fooled by that mask rect.
    Added a genuine white background <rect> as the FIRST child of <svg> (before <defs>)
    on all 8; verified by rasterization that the corner pixels are now opaque white.
2026-07-08 docs(hw): remove linorobot2 mentions — HW is generic hardware
    linorobot2 is only relevant to the firmware (openamr-platform-fw), which is a
    derivative of it. The hardware docs describe generic hardware, so genericized
    every linorobot reference: firmware pointed to `openamr-platform-fw`, the MPU6050
    driver mention dropped "linorobot2", and the reference-install Pi paths
    (~/linorobot2_ws, ~/linorobot2_hardware) renamed to neutral names.
2026-07-08 docs(sensors): add uniform diagram placeholders for IMU, LiDAR, camera
    Encoders already ships a wiring diagram; the other sensors only had text. Added
    diagram placeholders in the same robust, easily-removable format as the rest
    (a visible stub line + the prompt and replace-instruction inside an HTML comment,
    with the shared STYLE block) so they can't leak the prompt and place cleanly:
    - imu.md: MPU6500 I2C wiring (SDA18/SCL19, 3.3 V, 0x68)
    - lidar.md: RPLIDAR A1 -> CP2102 USB -> Pi
    - camera.md: Camera Module 3 (IMX708) -> CSI ribbon -> Pi
2026-07-08 docs(sensors): generate & place the IMU, LiDAR, camera wiring diagrams
    Replace the three placeholder blocks with the real SVGs (fixes the broken
    image references the link-checker flagged inside the placeholder comments).
    Wiring verified against the physical robot:
    - IMU: board is silkscreen-marked MPU-6050 but the actual silicon is an
    MPU6500 (WHO_AM_I 0x70), driven by the MPU9250 driver. Powered from the
    Teensy 3V3 pin; AD0 left floating (addr 0x68 = board default); on-board
    I2C pull-ups (no external parts).
    - LiDAR: USB adapter is a Slamtec STC-A0317-R03 (CP2102 bridge, 10c4:ea60).
    - Camera: Pi-4-style 15-pin FPC + a 15->22-pin CSI adapter for the Pi 5;
    connector is cam1 (camera.md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
2026-07-08 docs(bom): track width confirmed 0.46 m by tape-measure (close the 5 cm question)
    Re-measured centre-to-centre = 0.46 m, matching the firmware LR_WHEELS_DISTANCE.
    The CAD/URDF 0.4075 m is a CAD artifact and is rejected.
2026-07-08 docs(motor-control): add the manufacturer driver reference + the wiring diagram
    - Add the ZBLD.C20-120L2R manufacturer setup figure (full terminal layout, the
    SW1-SW6 DIP table, and the LED status codes) as a reference, with attribution
    to the ZD product manual.
    - Wire the existing driver-connections.svg into motors-drivers.md too (it was
    only referenced from wiring-pinout.md) — it shows the 4 terminals this robot
    actually uses out of the driver's twelve.
2026-07-08 fix(diagrams): imu green note overlap + system-block encoders x2 / generic battery
    - imu-wiring.svg: move the green '3.3 V, safe' note up out of the Teensy block
    (it was overlapping and getting clipped).
    - system-block.svg: show 'AS5040 x2' (one encoder per wheel, matching the 2x
    driver/motor/wheel labels) and make the battery generic ('24 V / battery'
    instead of lead-acid — the design is not tied to a battery chemistry).
2026-07-08 docs: make the battery generic (any 24 V pack), not tied to lead-acid
    The design only sees a 24 V bus, not a chemistry. Reword everywhere so lead-acid
    is the *reference build*, not a requirement:
    - Diagrams (system-block done earlier; wiring-harness, power-distribution): '24 V
    battery' instead of '2x 12 V lead-acid'.
    - README / AUTHORS: '24 V battery (reference build: 2x 12 V)'.
    - power.md: keep the at-rest voltage thresholds but scope them as reference
    lead-acid values, with a note to adjust for other chemistries (LiFePO4/Li-ion);
    generic battery-care wording.
    - BOM: list DM12-7S as the reference battery, noting any 24 V source works.
    The only lead-acid mentions left are explicitly la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
2026-07-08 docs: illustrate the README and LiDAR doc with real robot images
    Pull three images from the OpenAMRobot product repo and place them where they
    add the most context:
    - README hero: the base's front panel (E-stop, buttons, camera module).
    - README internal layout: the labelled cover-off top view (drive wheels,
    central bracket, RPLIDAR, electronics/wireless-charger zones).
    - README repository boundaries: the ecosystem diagram showing where
    openamr-platform-hw (CAD/chassis/electrical/BOM/manufacturing) sits.
    - lidar.md mounting: the same top view, showing the RPLIDAR's physical position.
    Doc-inline images kept in normal git so they render everywhere.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
2026-07-08 merge: mechanical CAD, BOM, datasheets & images from the OpenAMRobot product repo
    Bring the hardware content from the OpenAMRobot design repo into the release repo
    (same robot: Linorobot electronics upgraded to ZD BLDC + ZBLD.C20-120L2R + AS5040).
    - mechanical/cad/ — full STEP assembly, ~97 per-part production files (PDF/DXF/
    SLDPRT/SLDDRW/STEP), and the SolidWorks 2017 project. Stored via Git LFS.
    - mechanical/renderings/ + manufacturing/assembly/ — CAD renders, robot views, and
    the wheel-assembly sequence (+ video link).
    - manufacturing/bom/ — mechanical BOM (BOM_specs_MMP.xlsx + mechanical-bom.md),
    cross-linked from the electrical components-bom.md.
    - datasheets/ — ZD/ZLTec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
    [BOM_specs_MMP.xlsx, MMP.00.00.00.001 Front panel.DXF, MMP.00.00.00.001 Front panel.SLDDRW, MMP.00.00.00.001 Front panel.SLDPRT, MMP.00.00.00.001 Front panel.STEP, MMP.00.00.00.002 Back panel.DXF, MMP.00.00.00.002 Back panel.SLDDRW, MMP.00.00.00.002 Back panel.SLDPRT]
2026-07-08 fix(specs): correct the gearbox ratio to 1:25 (4GN 25K), not ~30:1
    The merged OpenAMRobot sizing calculations and mechanical BOM both give the
    gearbox as 4GN 25K = 1:25 (3000 rpm motor -> 120 rpm wheel), and our own BOM
    already flagged '~30:1' as unconfirmed (inferred from an analog part number).
    Reconcile everywhere per the (reliable) product repo:
    - 30:1 -> 1:25, ~100 rpm -> 120 rpm wheel, torque ~4.18 -> ~3.48 N.m/wheel.
    - mechanical no-load max ~1.26 m/s (software-capped 0.71 m/s) — link the sizing calcs.
    - note the motor suffix '-30S' is a ZD series code, not the ratio.
    - fixed in README, components-bom, motors-drivers, encoders, and signal-chain.svg.
    The firmware pins/config are unto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
2026-07-08 chore: plain-git binary attributes (drop LFS — not usable on public forks)
2026-07-08 docs(images): better hero + showcase the key images
    - README hero: swap the flat front-view CAD for the 3D transparent render
    (AMR_transparent) — shows the base and its internals in one shot.
    - README: add the 3D cut-away (AMR_uncovered) next to the annotated top view,
    and point to mechanical/ for more.
    - README IMU row: note the board is silkscreen-marked MPU-6050 but the silicon
    is a 6500 (WHO_AM_I 0x70) — removes the '6500 vs 6050' confusion.
    - mechanical/README: add a base-platform render gallery (transparent, cut-away,
    orthographic views, front panel).
    - product-architecture: add the dual-arm product-vision render (clearly labelled
    not-the-base).
    - drop the now-unused flat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
2026-07-08 docs(readme): add the real robot photo (AMR_SME_logistics) under the transparent hero
    Open with the transparent CAD hero (design) then the physical robot photo in an
    SME/logistics setting (reality) — design-then-built. Keeps AMR_transparent as
    the first image as requested.
2026-07-08 docs(authors): credit the mechanical/product design + upstream provenance
    - Expand Matthieu Vinet's entry with the mechanical/CAD merge, the cross-source
    reconciliation (gearbox 1:25, IMU 6050/6500, geometry), product-architecture,
    and CODE_OF_CONDUCT.
    - Credit Alex Reznichenko and the OpenAMRobot design team for the MMP mechanical
    design (chassis, wheel assembly, brackets), the mechanical BOM, and the product
    architecture.
    - Add an 'Upstream content' note: the mechanical CAD/BOM/datasheets/renders were
    merged from openAMRobot/openamr (MIT); datasheets remain manufacturer copyright.
2026-07-08 fix(docs): actually drop the AMR_uncovered references (regression)
    The earlier removal commit only deleted the .png but left the two image lines
    in README.md and mechanical/README.md — they rendered as broken images. This
    commits the doc edits that remove them (README cut-away line + the mechanical
    gallery cell, replaced by the front-panel render).
2026-07-08 chore(cad): ASCII-rename the ZLTech wheel files (drop 单出轴 → single-shaft)
    Non-ASCII filenames can break checkouts on some Windows setups (Alex's note).
    [ZLLG80ASM250-L V3.0single-shaft.SLDASM]
2026-07-08 chore(cad): move the 50 MB SolidWorks project to a GitHub Release asset
    The native SolidWorks zip is over GitHub's 50 MB threshold and bloats clones.
    Removed from the tree; the mechanical docs now point to the repo Releases for it.
    The neutral STEP full assembly stays in the repo for any-CAD use. Also drop the
    empty assets/videos/ placeholder (assembly video is an external link).
2026-07-11 Revise Wheel Assembly section with tutorial format
    Updated the wheel assembly section with a tutorial format and added a video link.
2026-07-12 Revise README for project status and hardware warnings
    Updated README to reflect the current status and added warnings about hardware connections.
2026-07-20 Update wiring-pinout.md with E-Stop button info
    Added details about emergency stop buttons and power distribution.
2026-07-20 Update E-Stop button discussion link and product info
    Updated the E-Stop button discussion link format and added additional product links for emergency buttons.
2026-07-20 Revise E-Stop button discussion and add schematic
    Updated the section on the E-Stop button and power distribution for clarity and added a schematic image.
2026-07-20 Revise E-Stop button discussion link in wiring-pinout
    Updated link text for E-Stop button discussion and removed redundant lines.
2026-08-29 legal: standardize original project material under MIT
2026-10-02 chore: set code owners for OpenAMRobot 2.0 (#8)
    Set .github/CODEOWNERS to the OpenAMRobot 2.0 owner assignment
    (team ground-truth document, section 5.4).
    Claude-Session: https://claude.ai/code/session_01TtEpmZ66TW3ufBTVZHLkCC
2026-10-16 docs: align IMU page with P-03 rev19.4
2026-10-16 docs: align LiDAR page with P-03 rev19.4
2026-10-24 datasheets: controller, near-field sensor, IMU and safety I/O references for the 2.0 pin map (#30)
    * datasheets: add controller, sensor and safety references
    Add vendor PDFs and metadata for the 2.0 pin map. Keep TI datasheets link-only under TI terms. Record the RM0468 repository upload limitation in its index.
    * datasheets: RM0468 as a link-only entry, no private Drive link
    Claude-Session: https://claude.ai/code/session_015uY6hFMbCNTirChFEieXEs
    * datasheets: drop TZBOT lift unit and WCM-300 manual; charger is WCM-500-24
    Signed-o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
2026-10-24 Update wiring-pinout.md wiring: remove uncertified E-stop recommendation and prices (fixes #25) (#31)
2026-10-24 ci: hardware repository checks (links, file formats, sizes, datasheet index) (#34)
    Adds tools/ci/check_hw_repo.py, its self-tests and a Hardware checks
    workflow. Fixes the ZLTech/drivers/ link it found in datasheets/README.md.
    The split SolidWorks archive is allowed against issue #33.
    Claude-Session: https://claude.ai/code/session_01Q9vAfam48xY6MGF7ZC42zW
2026-11-01 docs: cite BOM Issue 7.14, TDK EV_ICM-42688-P IMU board, component availability rule (signed off) (#41)
    * docs: cite BOM Issue 7.14, TDK EV_ICM-42688-P IMU board, availability rule
    - near-field.md, product-architecture.md, mechanical-bom.md: BOM Issue
    7.7 cited as current becomes BOM Issue 7.14. "Superseded by BOM
    Issue 7.7" history lines and the CHANGELOG history are unchanged.
    - imu.md, product-architecture.md: the 2.0 IMU board is the TDK
    EV_ICM-42688-P (was MIKROE-4237 6DOF IMU 14 Click); the MikroE
    datasheet readme and datasheets/README.md mark the Click schematic
    as reference only.
    - manufacturing/bom/README.md (new): BOM index and the component
    availability rule of P-03 r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
2026-11-01 datasheets: ZLTECH ZLLG80ASM250-L-B2 V1.01 double-shaft drawing and STEP (#28)
    * datasheets: ZLTECH ZLLG80ASM250-L-B2 V1.01 double-shaft drawing and STEP
    The selected 2.0 hub motor drawing (PDF, STEP, DWG) received from ZLTECH on
    2026-10-10. readme lists the key dimensions and the open points (100 kg
    per pair on the drawing vs 120 kg in the supplier email; brake coil data).
    * datasheets: ZLTECH B2 brake and load from the written answer of 18 Oct 2026
    readme: the brake engages with power off, 24 V DC, 12.5 W per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
